devsonni/Community-Extrusion-Compression-Moulding-Machies/README.md

# Community Extrusion & Compression Moulding Machines
