devsonni/Community-Extrusion-Compression-Moulding-Machies/Precious Plastic Parts (3D CAD)/EXTPRO-V1 1120.00-A Bearing Body _ Shaft.SLDASM

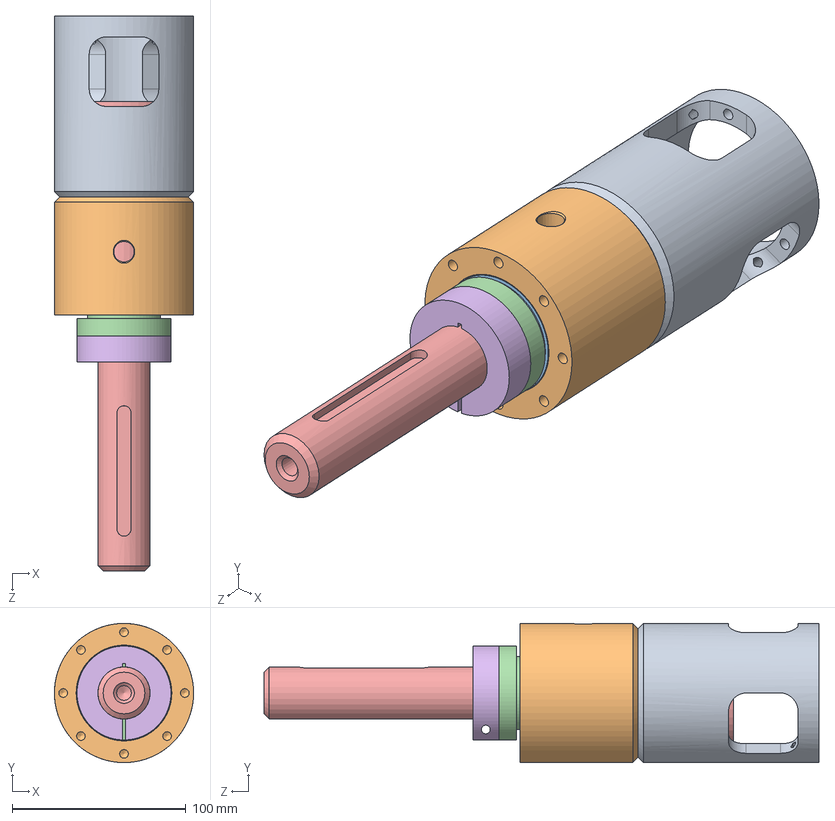
[picture p1: CAD file, 2021-08-28]
Precious Plastic Parts (3D CAD)/EXTPRO-V1 1120.00-A Bearing Body _ Shaft.SLDASM
80.0 x 80.0 x 319.0 mm
EXTPRO-V1 1121.01-A Transition Piece
EXTPRO-V1 1121.02-A Bearing body
EXTPRO-V1 02 Bearing seal-din3760-as_42x55x8-fkm x 2
EXTPRO-V1 1120.01-A Seal bearing spacer
EXTPRO-V1 1120.02-A Coupling Shaft
EXTPRO-V1 03 Shaft Clamp
