devsonni/Community-Extrusion-Compression-Moulding-Machies/Precious Plastic Parts (3D CAD)/EXTPRO-V1 3000.01-A Main frame.SLDPRT

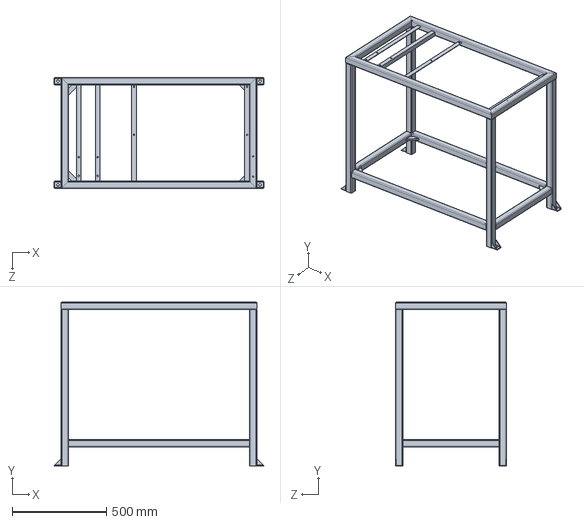
[picture p2: CAD file, 2021-08-28]
Precious Plastic Parts (3D CAD)/EXTPRO-V1 3000.01-A Main frame.SLDPRT
1114.8 x 870.0 x 590.0 mm
