devsonni/Community-Extrusion-Compression-Moulding-Machies/Precious Plastic Parts (3D CAD)/EXTPRO-V1 3000.00-A Frame.SLDASM

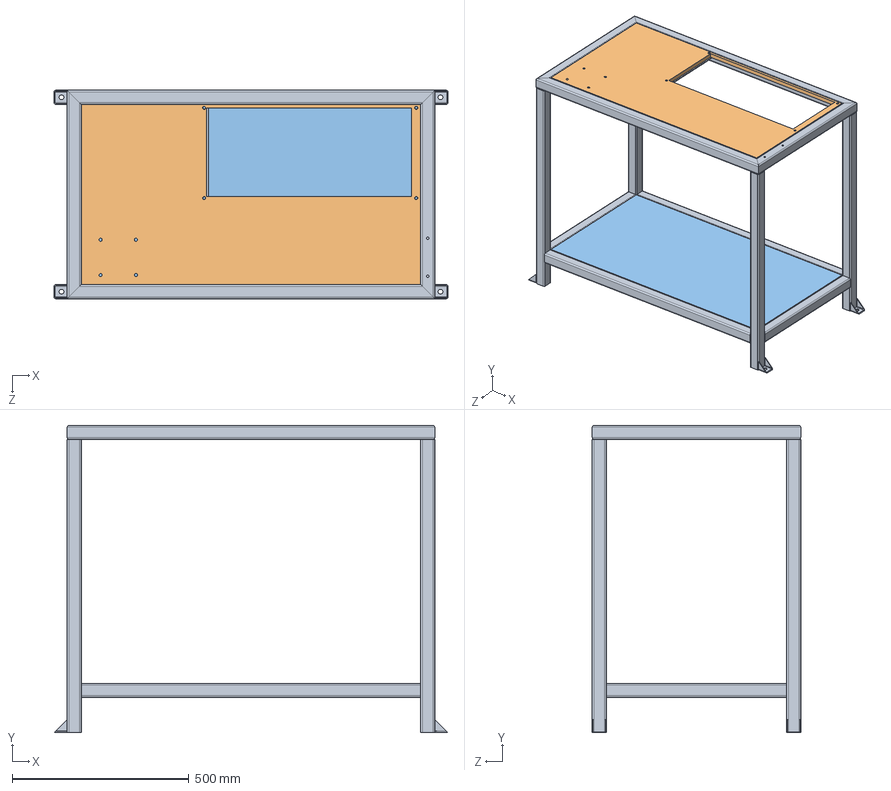
[picture p3: CAD file, 2021-08-28]
Precious Plastic Parts (3D CAD)/EXTPRO-V1 3000.00-A Frame.SLDASM
1114.8 x 870.0 x 590.0 mm
EXTPRO-V1 3000.01-A Main frame
EXTPRO-V1 3000.02-A Top shelf
EXTPRO-V1 3000.03-A Bottom shelf
