devsonni/Community-Extrusion-Compression-Moulding-Machies/Precious Plastic Parts (3D CAD)/EXTPRO-V1 1130.00-A Barrel inlet.SLDASM

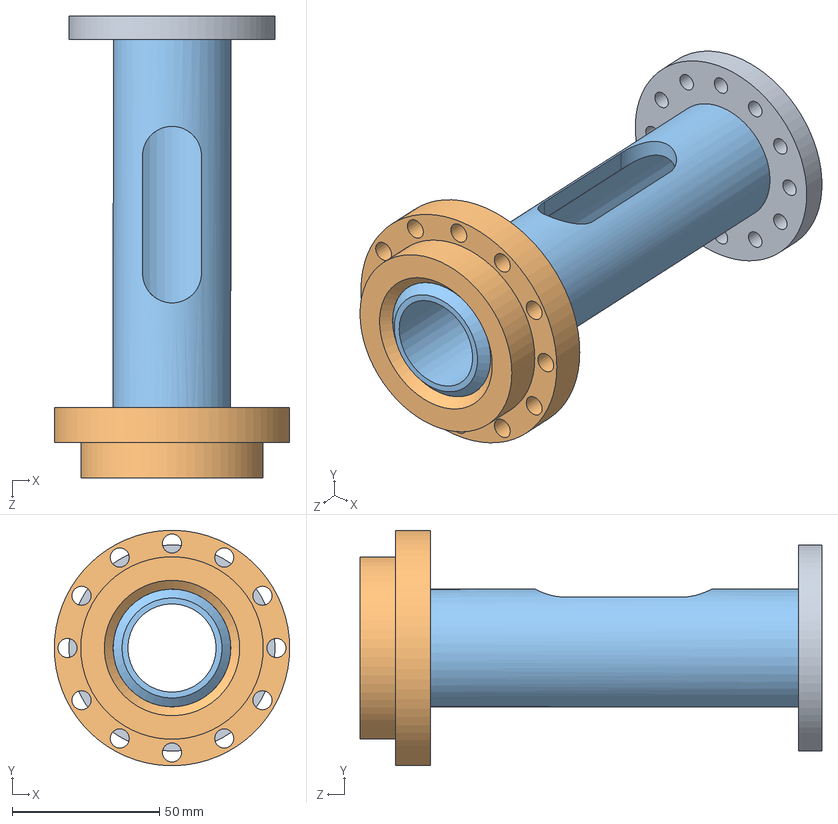
[picture p4: CAD file, 2021-08-28]
Precious Plastic Parts (3D CAD)/EXTPRO-V1 1130.00-A Barrel inlet.SLDASM
80.0 x 79.9 x 157.0 mm
EXTPRO-V1 1130.01-A Barrel inlet
EXTPRO-V1 1130.02-A Barrel flange 1
EXTPRO-V1 1130.03-A Barrel flange 2
