devsonni/Community-Extrusion-Compression-Moulding-Machies/Precious Plastic Parts (3D CAD)/Bearing Body Assembly.SLDASM

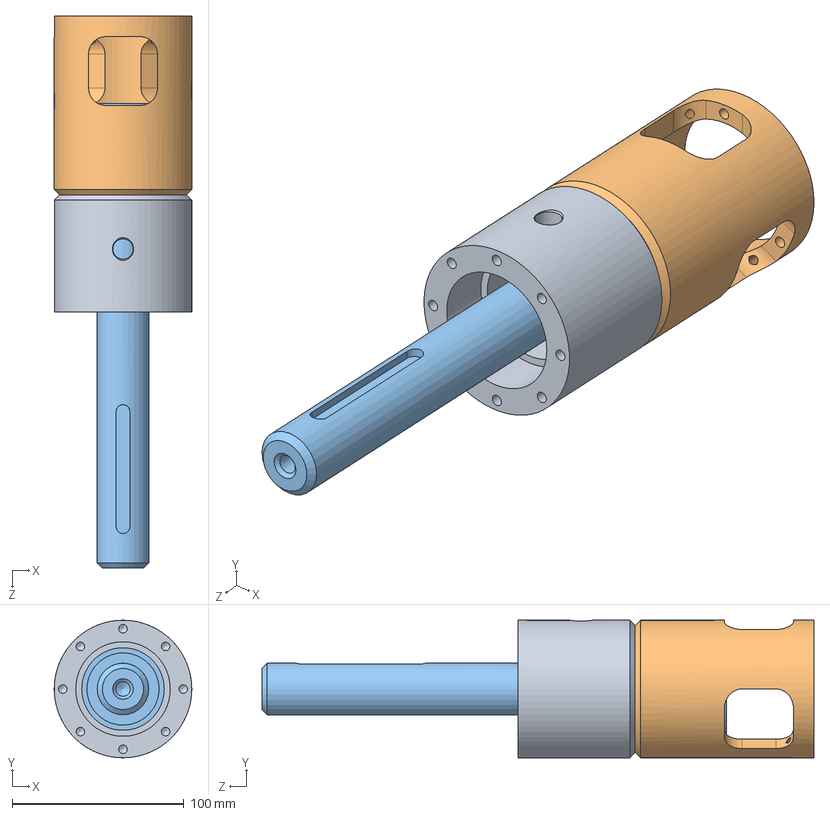
[picture p5: CAD file, 2021-08-28]
Precious Plastic Parts (3D CAD)/Bearing Body Assembly.SLDASM
80.0 x 80.0 x 321.0 mm
EXTPRO-V1 1121.02-A Bearing body
EXTPRO-V1 1121.01-A Transition Piece
EXTPRO-V1 1120.02-A Coupling Shaft
