devsonni/Community-Extrusion-Compression-Moulding-Machies/Precious Plastic Parts (3D CAD)/EXTPRO-V1 1140.00-A Barrel.SLDASM

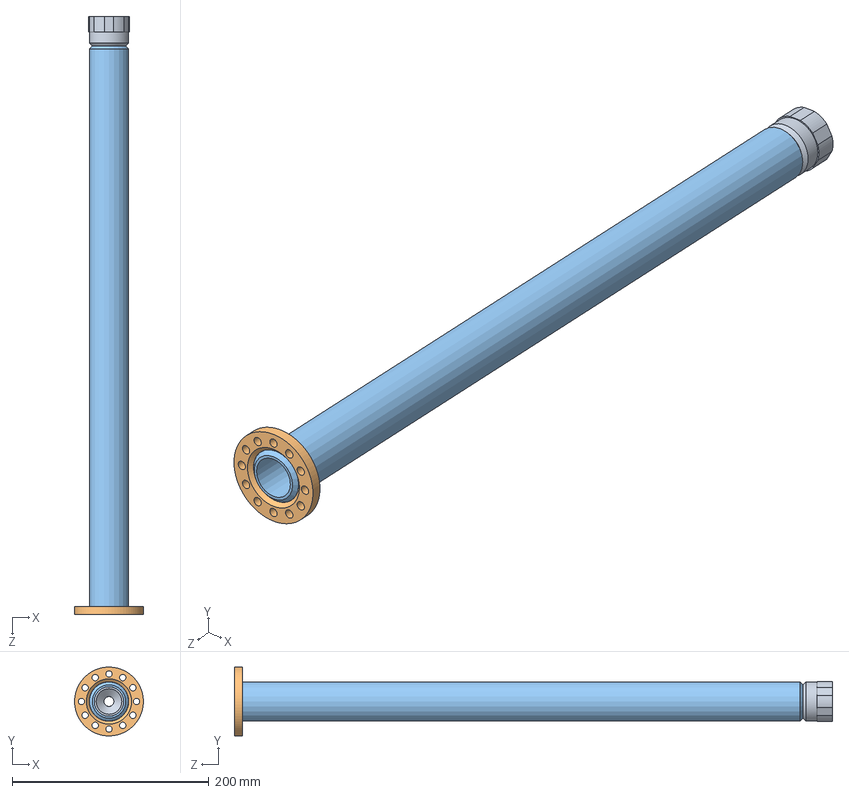
[picture p6: CAD file, 2021-08-28]
Precious Plastic Parts (3D CAD)/EXTPRO-V1 1140.00-A Barrel.SLDASM
70.0 x 70.0 x 608.0 mm
EXTPRO-V1 1140.01-A Barrel
EXTPRO-V1 1140.02-A Barrel flange
EXTPRO-V1 1140.03-A Barrel tip
