devsonni/Community-Extrusion-Compression-Moulding-Machies/Precious Plastic Parts (3D CAD)/EXTPRO-V1 1110.00-A Gearbox flange.sldasm

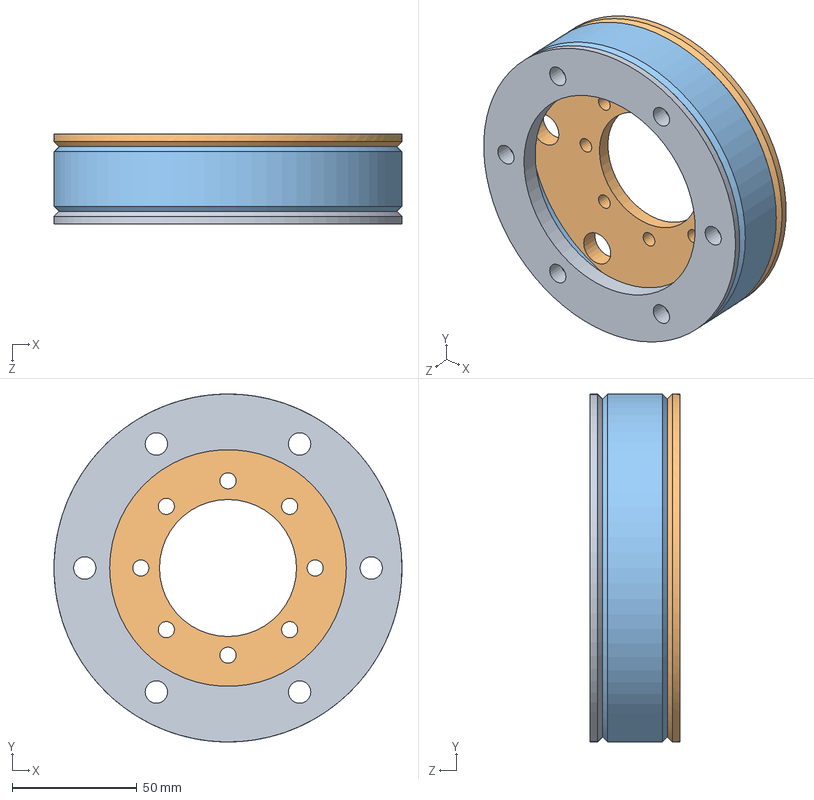
[picture p7: CAD file, 2021-08-28]
Precious Plastic Parts (3D CAD)/EXTPRO-V1 1110.00-A Gearbox flange.sldasm
139.7 x 139.7 x 36.0 mm
EXTPRO-V1 1110.01-A Flange Spacer
EXTPRO-V1 1110.02-A Flange 1
EXTPRO-V1 1110.03-A Flange 2
