devsonni/Community-Extrusion-Compression-Moulding-Machies/Precious Plastic Parts (3D CAD)/EXTPRO-V1 1200.00-A Cone Hopper.SLDASM

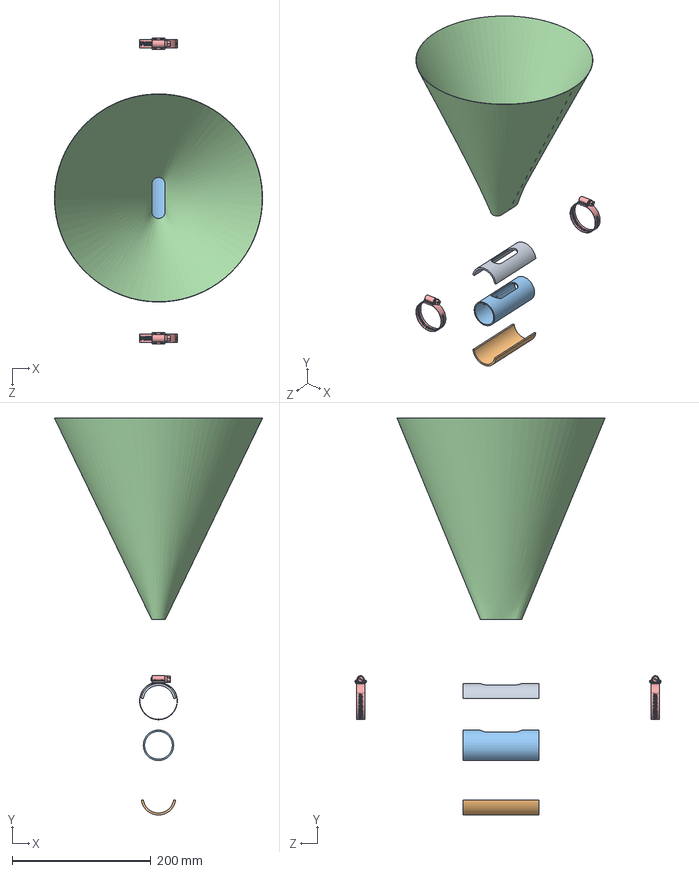
[picture p8: CAD file, 2021-08-28]
Precious Plastic Parts (3D CAD)/EXTPRO-V1 1200.00-A Cone Hopper.SLDASM
300.0 x 572.2 x 441.7 mm
EXTPRO-V1 1200.01-A Top
EXTPRO-V1 1200.02-A Bottom
EXTPRO-V1 1200.03-A Insulation
EXTPRO-V1 1200.04-A Cone
EXTPRO-V1 10 Clamp x 2
