devsonni/Community-Extrusion-Compression-Moulding-Machies/Precious Plastic Parts (3D CAD)/EXTPRO-V1 1121.00-A Bearing body.SLDASM

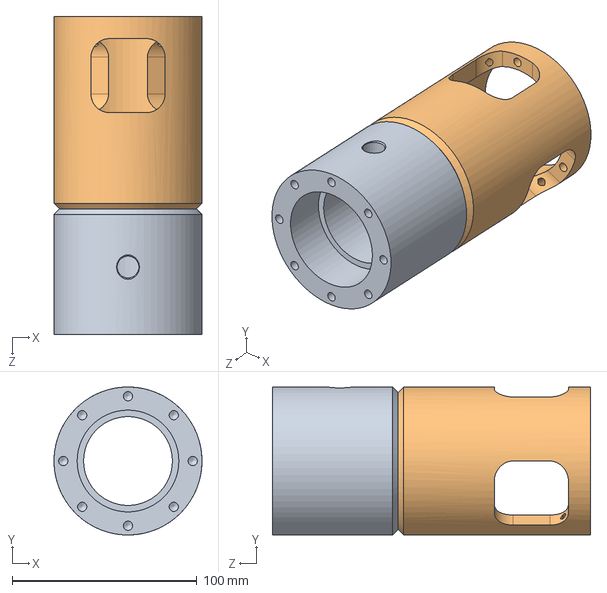
[picture p9: CAD file, 2021-08-28]
Precious Plastic Parts (3D CAD)/EXTPRO-V1 1121.00-A Bearing body.SLDASM
80.0 x 80.0 x 172.0 mm
EXTPRO-V1 1121.01-A Transition Piece
EXTPRO-V1 1121.02-A Bearing body
