devsonni/Community-Extrusion-Compression-Moulding-Machies/Laser cut files/Modified laser cut files/Flange2_QTY_1.dxf

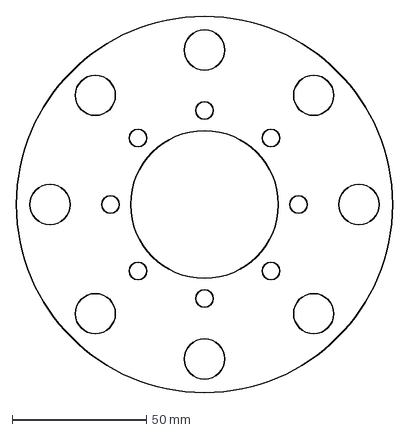
[picture p10: CAD file, 2021-08-31]
Laser cut files/Modified laser cut files/Flange2_QTY_1.dxf
140.0 x 140.0 mm
