devsonni/Community-Extrusion-Compression-Moulding-Machies/Laser cut files/Precious Plastic/EXTPRO-V1 2100.05-A Side 3 - QTY_2.DXF

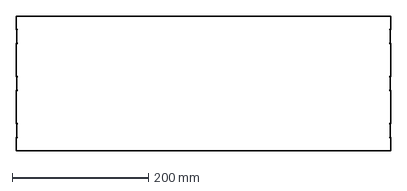
[picture p11: CAD file, 2021-08-31]
Laser cut files/Precious Plastic/EXTPRO-V1 2100.05-A Side 3 - QTY_2.DXF
550.0 x 198.0 mm
