devsonni/Community-Extrusion-Compression-Moulding-Machies/Laser cut files/Modified laser cut files/Flange1_QTY_1.DXF

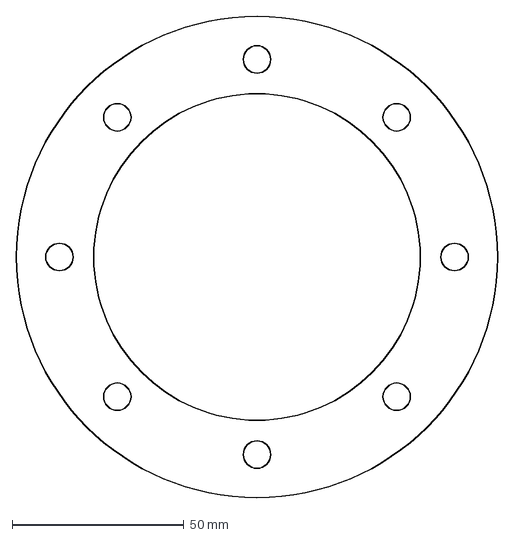
[picture p12: CAD file, 2021-08-31]
Laser cut files/Modified laser cut files/Flange1_QTY_1.DXF
140.0 x 140.0 mm
