devsonni/Community-Extrusion-Compression-Moulding-Machies/Laser cut files/Precious Plastic/EXTPRO-V1 2100.01-A Cover - QTY_1.DXF

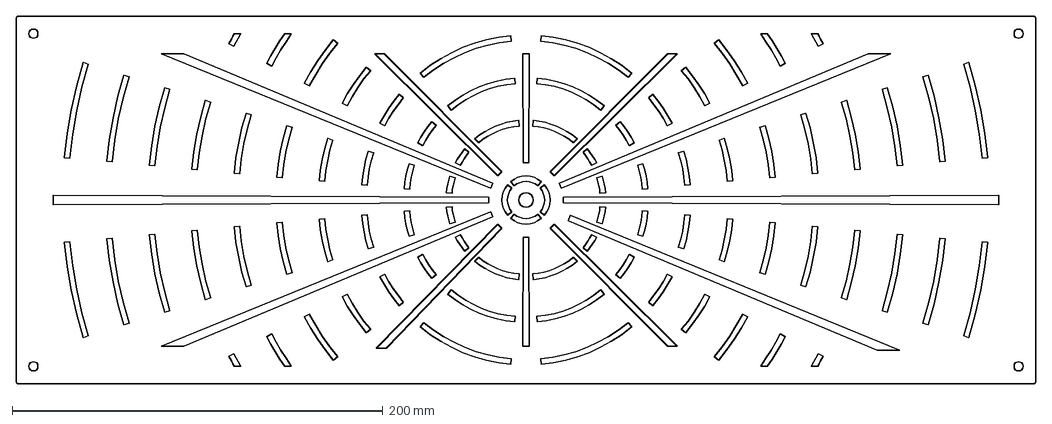
[picture p13: CAD file, 2021-08-31]
Laser cut files/Precious Plastic/EXTPRO-V1 2100.01-A Cover - QTY_1.DXF
550.0 x 198.0 mm
