devsonni/Community-Extrusion-Compression-Moulding-Machies/Precious Plastic Parts (3D CAD)/EXTPRO-V1 2100.01-A Cover.SLDPRT

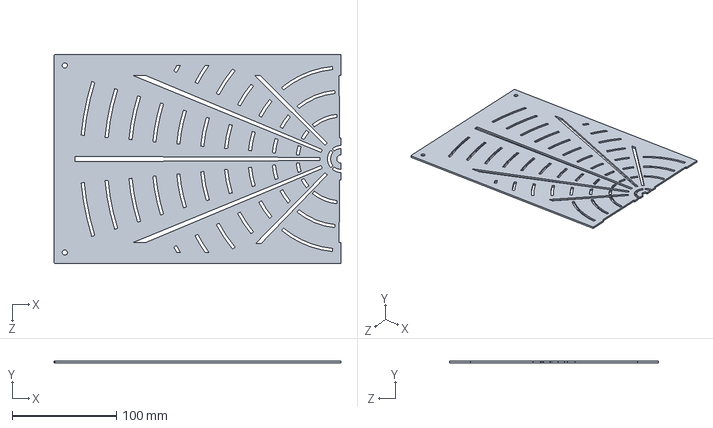
[picture p14: CAD file, 2021-08-28]
Precious Plastic Parts (3D CAD)/EXTPRO-V1 2100.01-A Cover.SLDPRT
275.0 x 2.00 x 200.0 mm
