devsonni/Community-Extrusion-Compression-Moulding-Machies/Laser cut files/Modified laser cut files/Front_Electrical_QTY_1.DXF

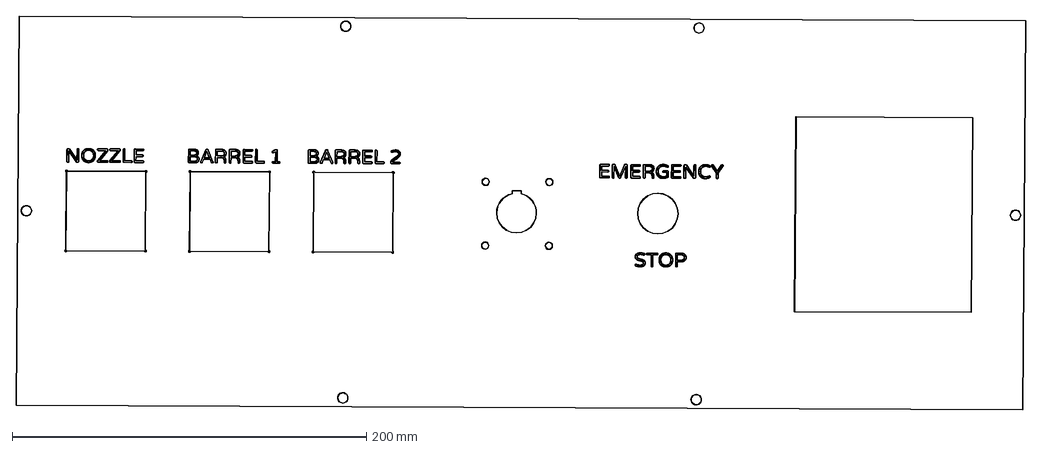
[picture p15: CAD file, 2021-08-31]
Laser cut files/Modified laser cut files/Front_Electrical_QTY_1.DXF
570.2 x 222.4 mm
