devsonni/Community-Extrusion-Compression-Moulding-Machies/Laser cut files/Precious Plastic/EXTPRO-V1 2100.03-A Side 2 - QTY_1.DXF

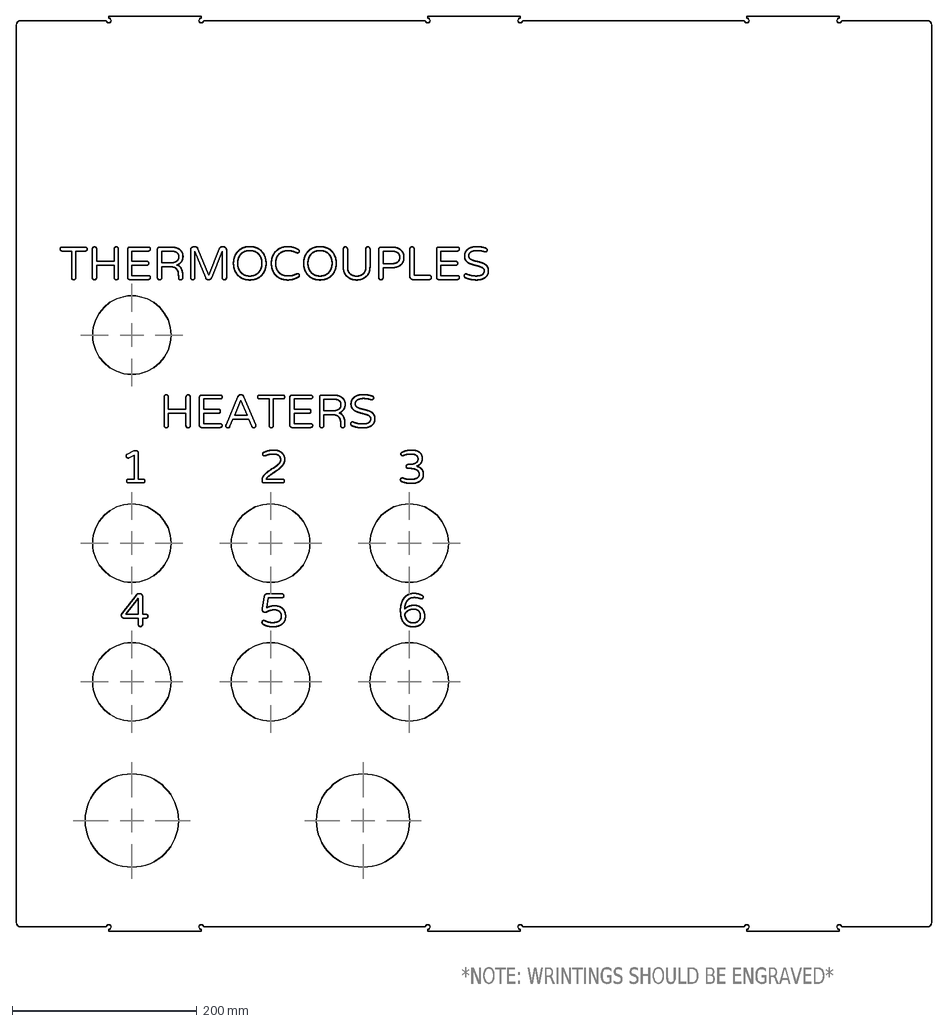
[picture p16: CAD file, 2021-08-31]
Laser cut files/Precious Plastic/EXTPRO-V1 2100.03-A Side 2 - QTY_1.DXF
*NOTE: WRINTINGS SHOULD BE ENGRAVED*
