devsonni/Community-Extrusion-Compression-Moulding-Machies/Precious Plastic Parts (3D CAD)/EXTPRO-V1 1140.02-A Barrel flange.sldprt

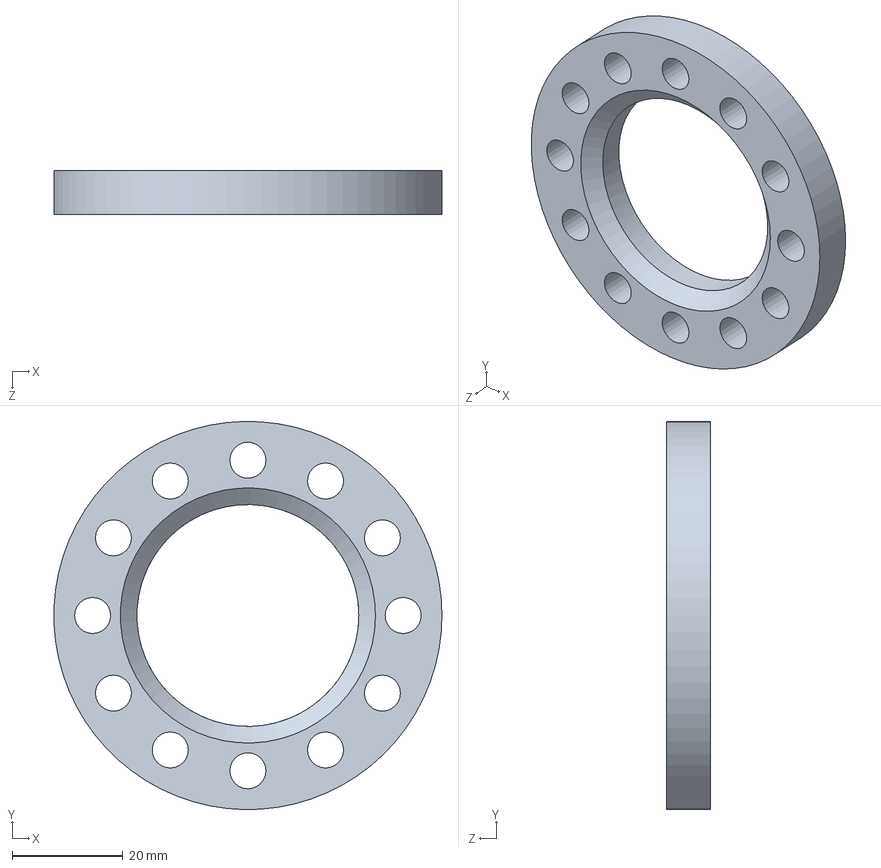
[picture p17: CAD file, 2021-08-28]
Precious Plastic Parts (3D CAD)/EXTPRO-V1 1140.02-A Barrel flange.sldprt
70.0 x 70.0 x 8.00 mm
