devsonni/Community-Extrusion-Compression-Moulding-Machies/Laser cut files/Precious Plastic/EXTPRO-V1 2100.04-A Side 1 - QTY_1.DXF

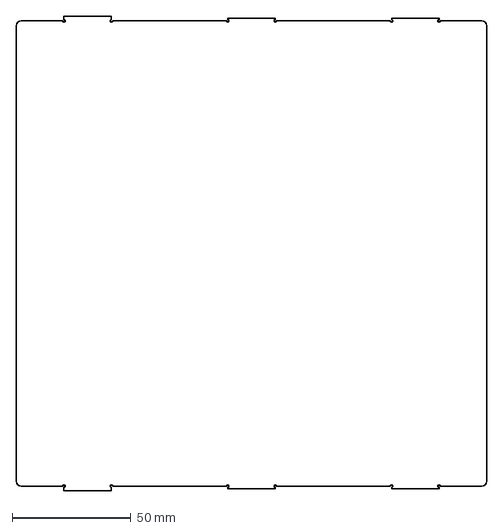
[picture p18: CAD file, 2021-08-31]
Laser cut files/Precious Plastic/EXTPRO-V1 2100.04-A Side 1 - QTY_1.DXF
198.0 x 200.0 mm
