devsonni/Community-Extrusion-Compression-Moulding-Machies/Precious Plastic Parts (3D CAD)/EXTPRO-V1 21 E Stop Button.SLDPRT

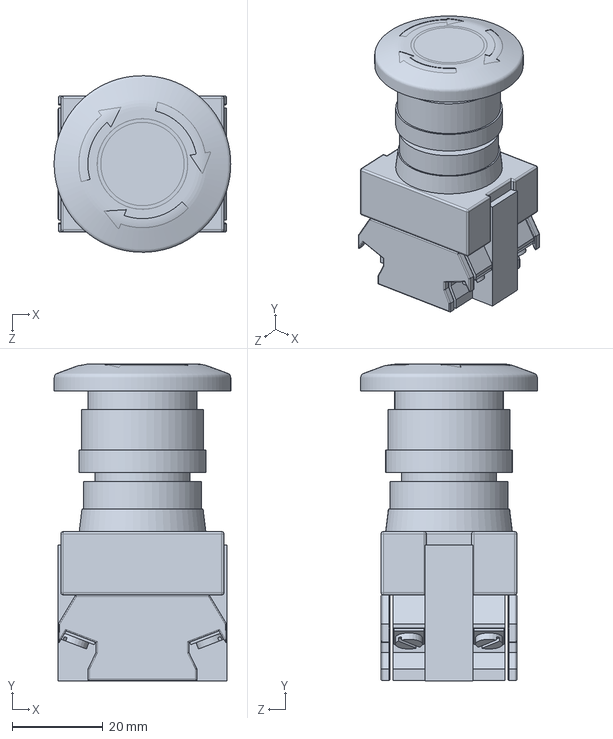
[picture p19: CAD file, 2021-08-28]
Precious Plastic Parts (3D CAD)/EXTPRO-V1 21 E Stop Button.SLDPRT
39.0 x 70.0 x 39.0 mm
