devsonni/Community-Extrusion-Compression-Moulding-Machies/Precious Plastic Parts (3D CAD)/EXTPRO-V1 18 Solid state relay.SLDPRT

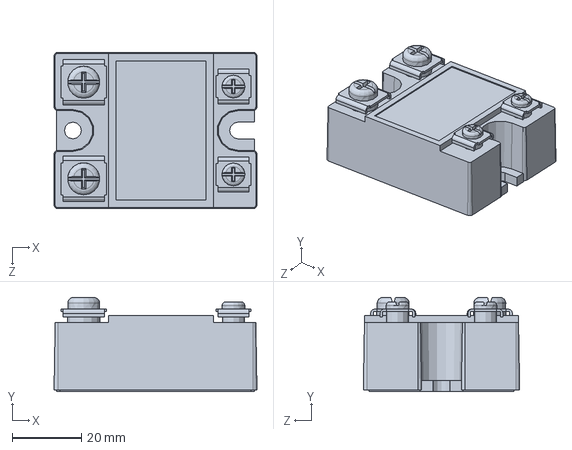
[picture p20: CAD file, 2021-08-28]
Precious Plastic Parts (3D CAD)/EXTPRO-V1 18 Solid state relay.SLDPRT
58.7 x 27.2 x 45.2 mm
