devsonni/Community-Extrusion-Compression-Moulding-Machies/Precious Plastic Parts (3D CAD)/EXTPRO-V1 2100.04-A Side 1.SLDPRT

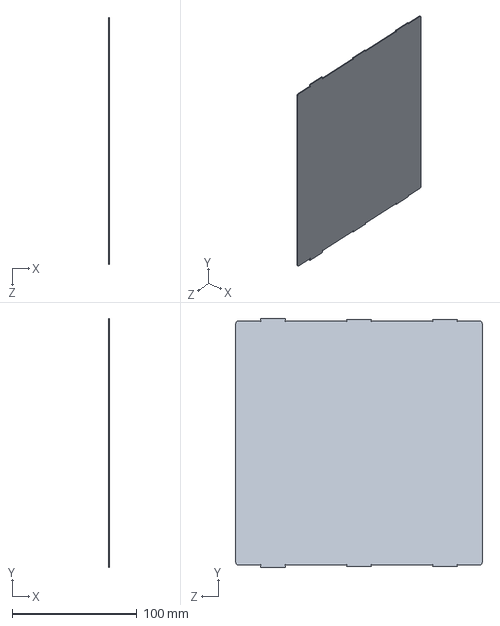
[picture p21: CAD file, 2021-08-28]
Precious Plastic Parts (3D CAD)/EXTPRO-V1 2100.04-A Side 1.SLDPRT
1.00 x 200.0 x 198.0 mm
