devsonni/Community-Extrusion-Compression-Moulding-Machies/Precious Plastic Parts (3D CAD)/EXTPRO-V1 1100.01-A Nozzle.sldprt

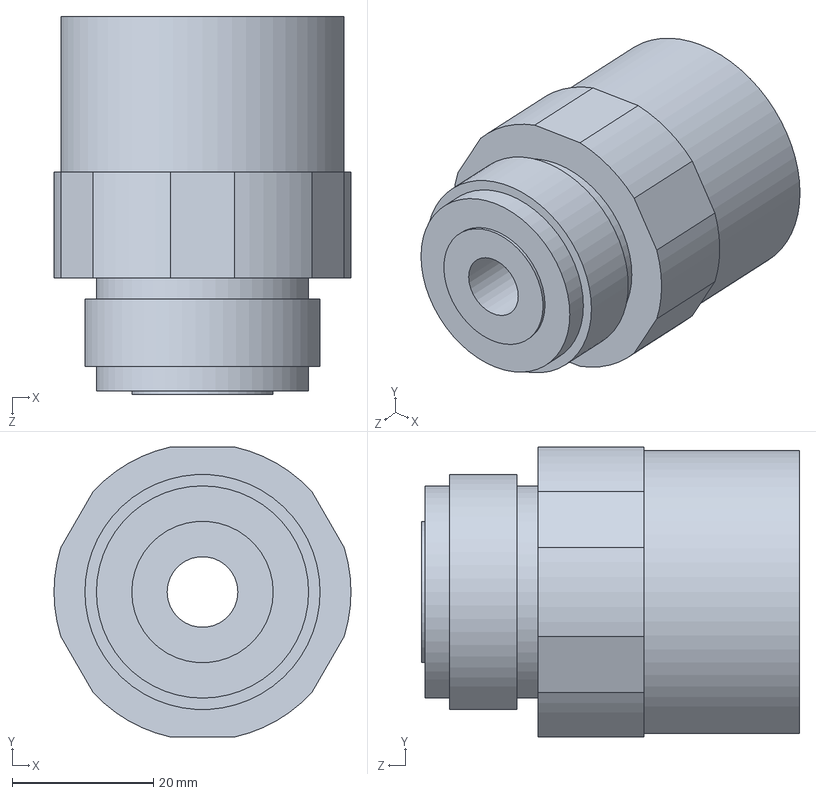
[picture p22: CAD file, 2021-08-28]
Precious Plastic Parts (3D CAD)/EXTPRO-V1 1100.01-A Nozzle.sldprt
42.0 x 41.0 x 53.5 mm
