devsonni/Community-Extrusion-Compression-Moulding-Machies/Precious Plastic Parts (3D CAD)/EXTPRO-V1 2100.05-A Side 3.SLDPRT

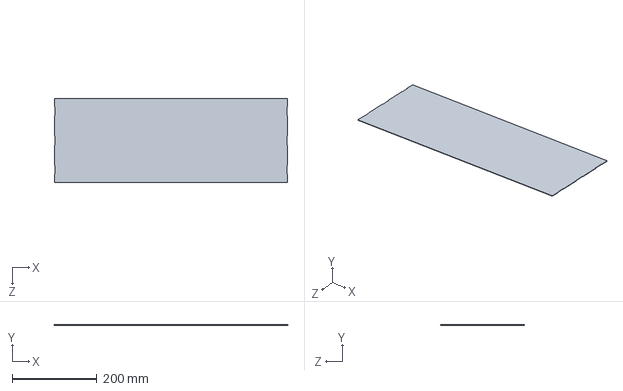
[picture p23: CAD file, 2021-08-28]
Precious Plastic Parts (3D CAD)/EXTPRO-V1 2100.05-A Side 3.SLDPRT
550.0 x 1.00 x 198.0 mm
