devsonni/Community-Extrusion-Compression-Moulding-Machies/Precious Plastic Parts (3D CAD)/EXTPRO-V1 1110.02-A Flange 1.sldprt

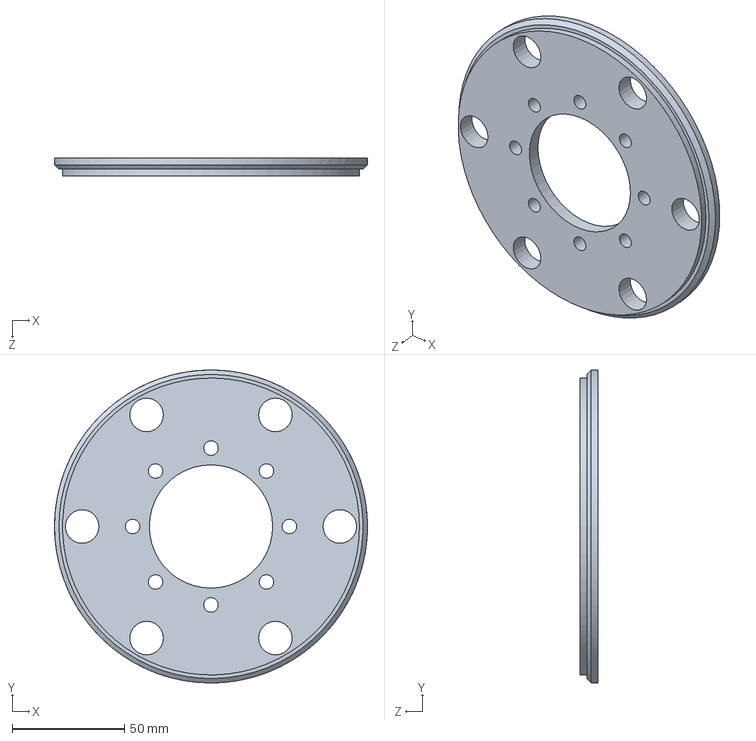
[picture p24: CAD file, 2021-08-28]
Precious Plastic Parts (3D CAD)/EXTPRO-V1 1110.02-A Flange 1.sldprt
139.7 x 139.7 x 8.00 mm
