devsonni/Community-Extrusion-Compression-Moulding-Machies/Precious Plastic Parts (3D CAD)/EXTPRO-V1 1140.01-A Barrel.sldprt

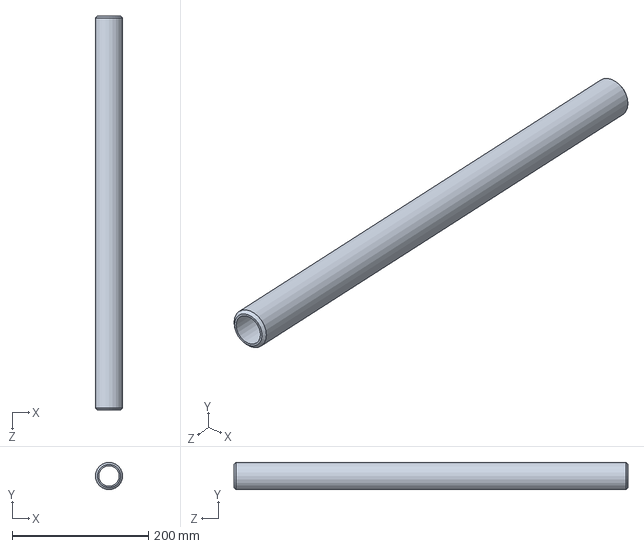
[picture p25: CAD file, 2021-08-28]
Precious Plastic Parts (3D CAD)/EXTPRO-V1 1140.01-A Barrel.sldprt
40.0 x 40.0 x 578.0 mm
