devsonni/Community-Extrusion-Compression-Moulding-Machies/Precious Plastic Parts (3D CAD)/EXTPRO-V1 16 PID Controller.SLDPRT

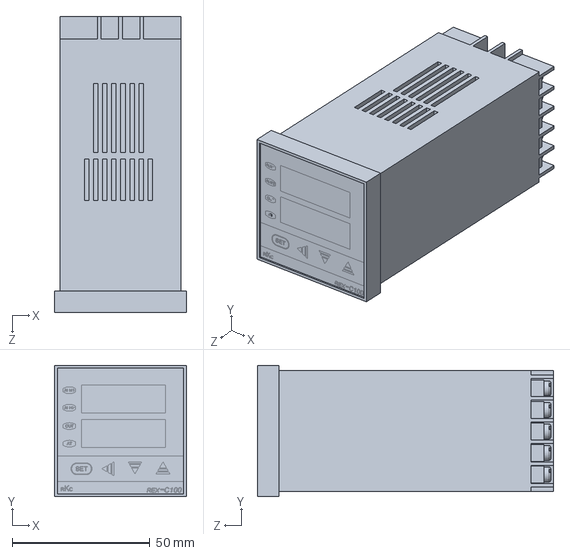
[picture p26: CAD file, 2021-08-28]
Precious Plastic Parts (3D CAD)/EXTPRO-V1 16 PID Controller.SLDPRT
47.8 x 47.6 x 107.4 mm
