devsonni/Community-Extrusion-Compression-Moulding-Machies/Precious Plastic Parts (3D CAD)/EXTPRO-V1 1130.03-A Barrel flange 2.sldprt

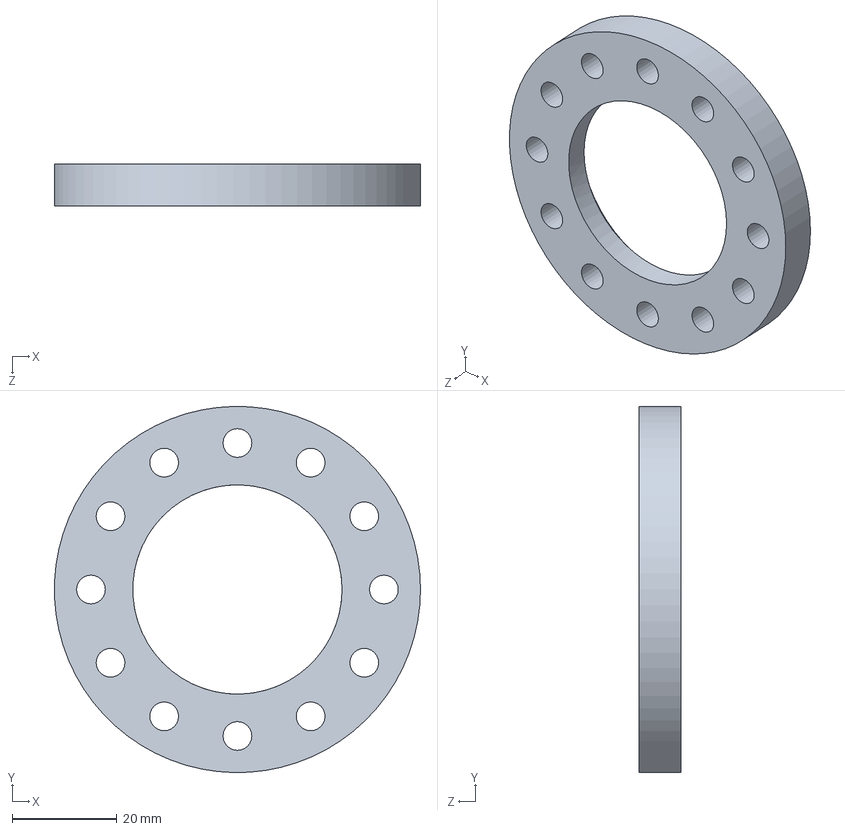
[picture p27: CAD file, 2021-08-28]
Precious Plastic Parts (3D CAD)/EXTPRO-V1 1130.03-A Barrel flange 2.sldprt
70.0 x 70.0 x 8.00 mm
