devsonni/Community-Extrusion-Compression-Moulding-Machies/Precious Plastic Parts (3D CAD)/EXTPRO-V1 1130.01-A Barrel inlet.SLDPRT

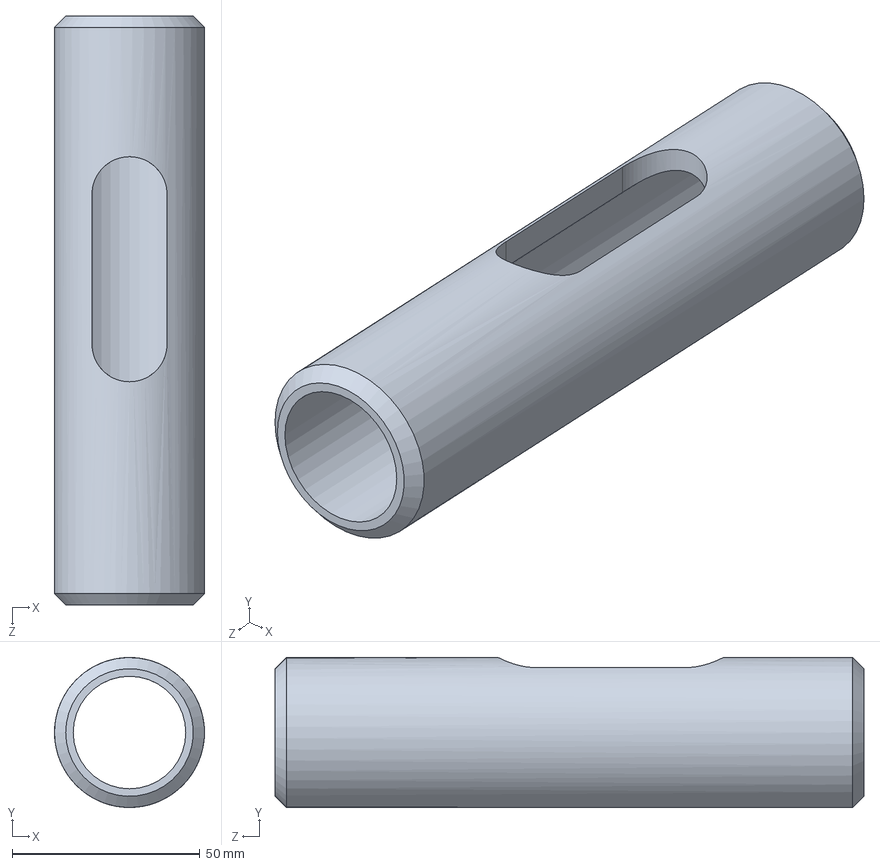
[picture p28: CAD file, 2021-08-28]
Precious Plastic Parts (3D CAD)/EXTPRO-V1 1130.01-A Barrel inlet.SLDPRT
40.0 x 40.0 x 157.0 mm
