devsonni/Community-Extrusion-Compression-Moulding-Machies/Precious Plastic Parts (3D CAD)/EXTPRO-V1 1120.01-A Seal bearing spacer.sldprt

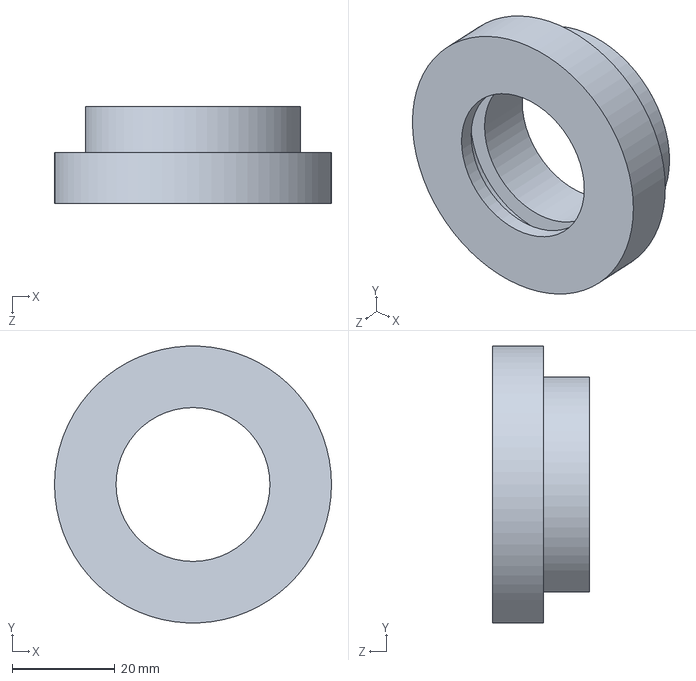
[picture p29: CAD file, 2021-08-28]
Precious Plastic Parts (3D CAD)/EXTPRO-V1 1120.01-A Seal bearing spacer.sldprt
54.0 x 53.9 x 19.0 mm
