devsonni/Community-Extrusion-Compression-Moulding-Machies/Precious Plastic Parts (3D CAD)/EXTPRO-V1 1121.02-A Bearing body.sldprt

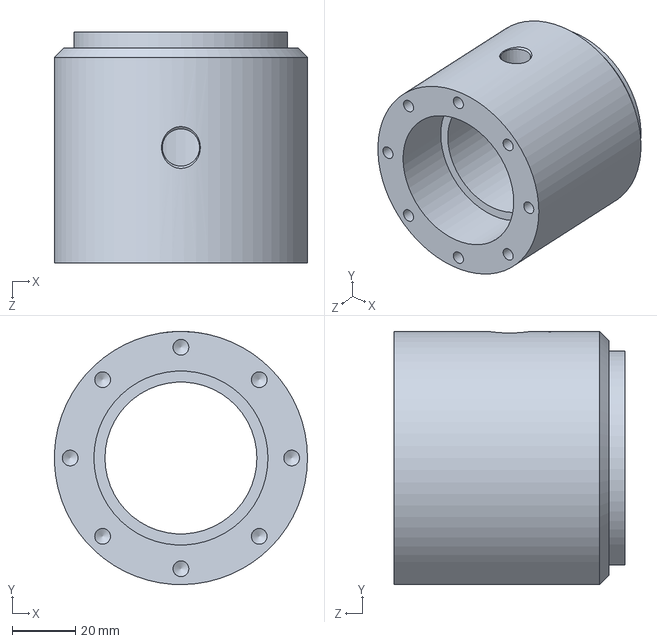
[picture p30: CAD file, 2021-08-28]
Precious Plastic Parts (3D CAD)/EXTPRO-V1 1121.02-A Bearing body.sldprt
80.0 x 80.0 x 73.0 mm
