devsonni/Community-Extrusion-Compression-Moulding-Machies/Precious Plastic Parts (3D CAD)/EXTPRO-V1 1120.02-A Coupling Shaft.sldprt

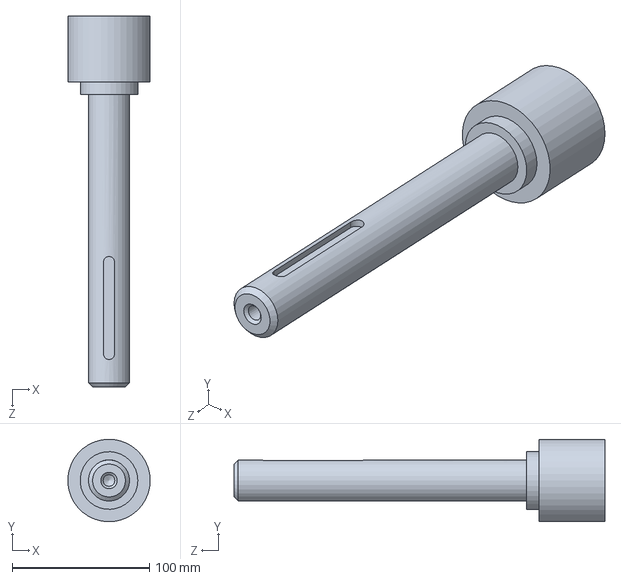
[picture p31: CAD file, 2021-08-28]
Precious Plastic Parts (3D CAD)/EXTPRO-V1 1120.02-A Coupling Shaft.sldprt
60.0 x 60.0 x 270.0 mm
