devsonni/Community-Extrusion-Compression-Moulding-Machies/Precious Plastic Parts (3D CAD)/EXTPRO-V1 2100.02-A Front.SLDPRT

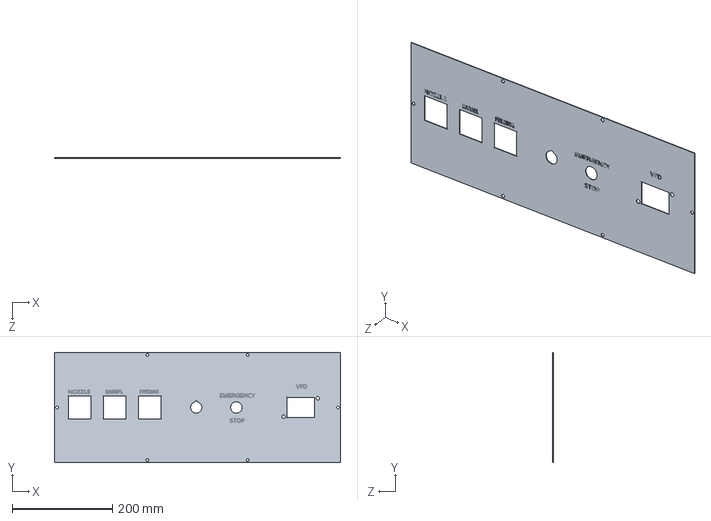
[picture p32: CAD file, 2021-08-28]
Precious Plastic Parts (3D CAD)/EXTPRO-V1 2100.02-A Front.SLDPRT
570.0 x 220.0 x 1.00 mm
