devsonni/Community-Extrusion-Compression-Moulding-Machies/Precious Plastic Parts (3D CAD)/EXTPRO-V1 24 Cable gland M20.SLDPRT

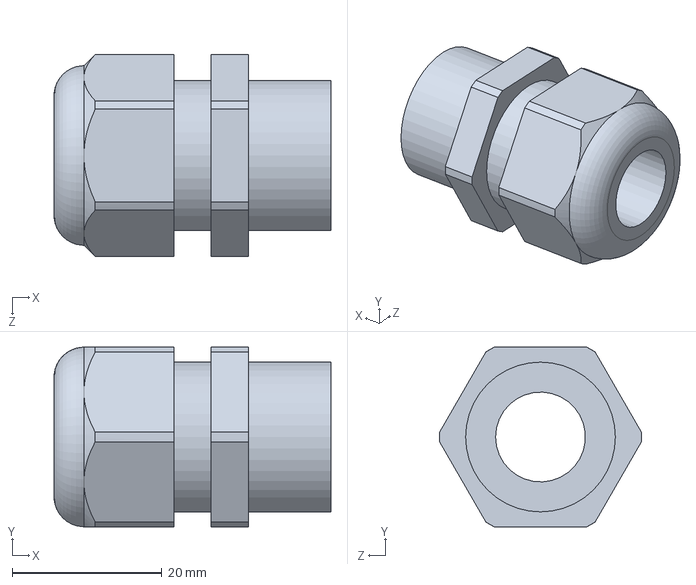
[picture p33: CAD file, 2021-08-28]
Precious Plastic Parts (3D CAD)/EXTPRO-V1 24 Cable gland M20.SLDPRT
37.0 x 24.0 x 27.0 mm
