devsonni/Community-Extrusion-Compression-Moulding-Machies/Precious Plastic Parts (3D CAD)/EXTPRO-V1 1121.01-A Transition Piece.sldprt

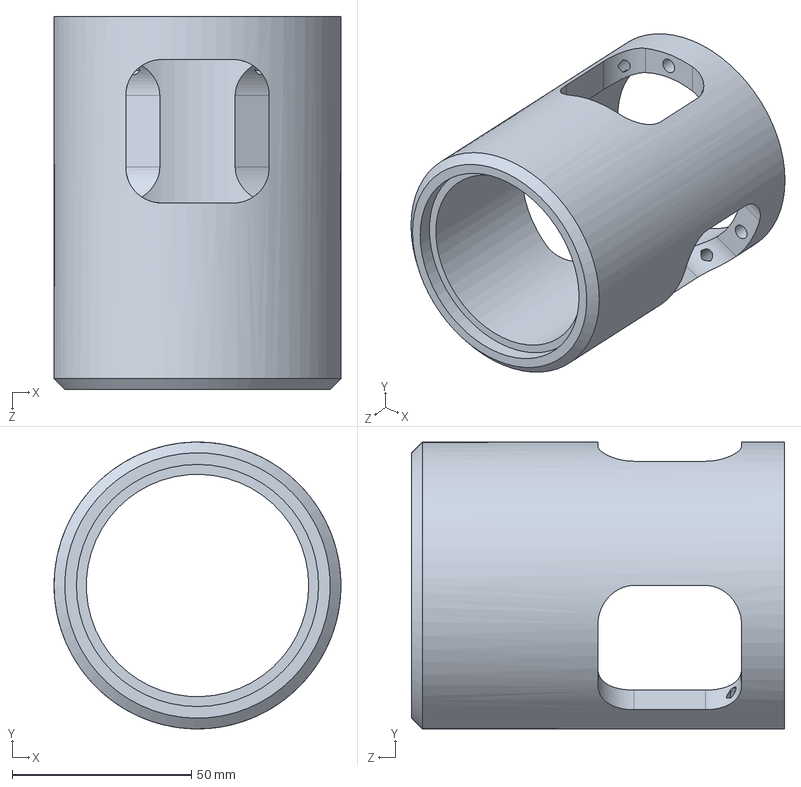
[picture p34: CAD file, 2021-08-28]
Precious Plastic Parts (3D CAD)/EXTPRO-V1 1121.01-A Transition Piece.sldprt
80.0 x 80.0 x 104.0 mm
