devsonni/Community-Extrusion-Compression-Moulding-Machies/Precious Plastic Parts (3D CAD)/EXTPRO-V1 20 3 Pole switch.SLDPRT

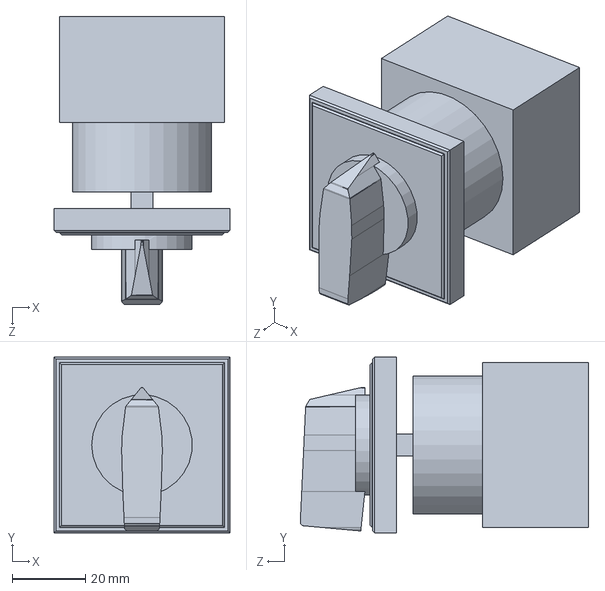
[picture p35: CAD file, 2021-08-28]
Precious Plastic Parts (3D CAD)/EXTPRO-V1 20 3 Pole switch.SLDPRT
48.0 x 48.0 x 78.7 mm
