devsonni/Community-Extrusion-Compression-Moulding-Machies/Precious Plastic Parts (3D CAD)/EXTPRO-V1 3000.02-A Support.SLDPRT

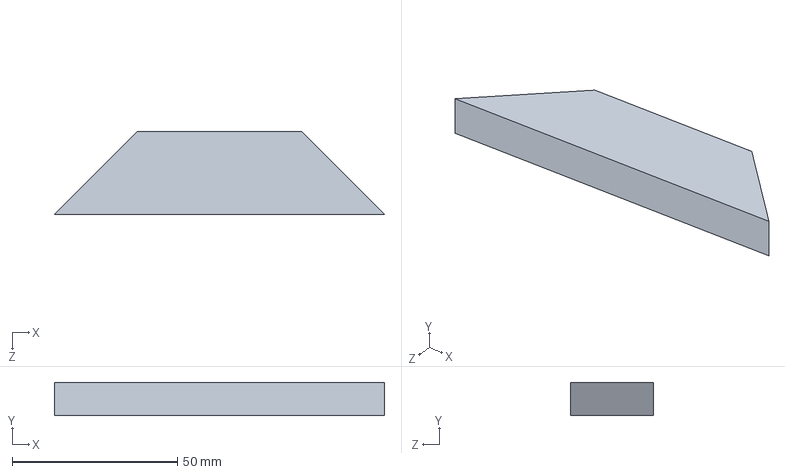
[picture p36: CAD file, 2021-08-28]
Precious Plastic Parts (3D CAD)/EXTPRO-V1 3000.02-A Support.SLDPRT
100.0 x 10.0 x 25.0 mm
