devsonni/Community-Extrusion-Compression-Moulding-Machies/Precious Plastic Parts (3D CAD)/EXTPRO-V1 19 Relay heat sink.SLDPRT

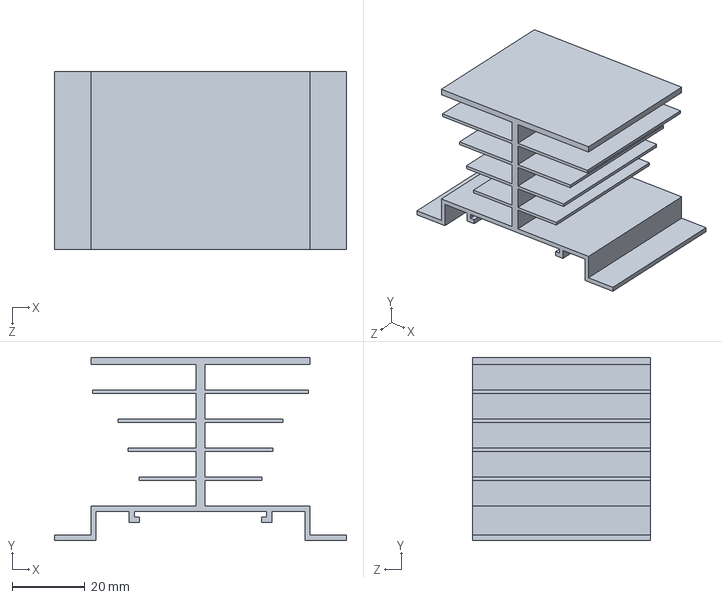
[picture p37: CAD file, 2021-08-28]
Precious Plastic Parts (3D CAD)/EXTPRO-V1 19 Relay heat sink.SLDPRT
80.5 x 50.5 x 49.0 mm
