devsonni/Community-Extrusion-Compression-Moulding-Machies/Precious Plastic Parts (3D CAD)/EXTPRO-V1 1110.01-A Flange Spacer.sldprt

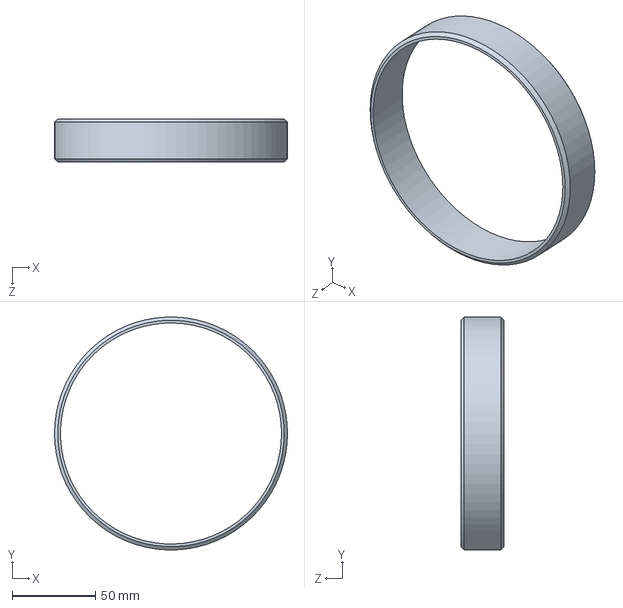
[picture p38: CAD file, 2021-08-28]
Precious Plastic Parts (3D CAD)/EXTPRO-V1 1110.01-A Flange Spacer.sldprt
139.7 x 139.6 x 26.0 mm
