devsonni/Community-Extrusion-Compression-Moulding-Machies/Precious Plastic Parts (3D CAD)/EXTPRO-V1 2100.06-A Cover attachment.SLDPRT

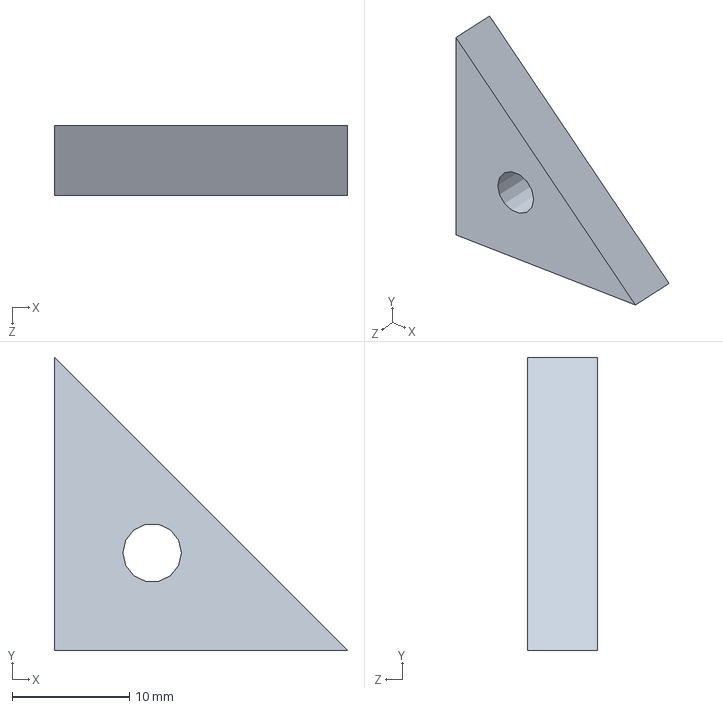
[picture p39: CAD file, 2021-08-28]
Precious Plastic Parts (3D CAD)/EXTPRO-V1 2100.06-A Cover attachment.SLDPRT
25.0 x 25.0 x 6.00 mm
