devsonni/Community-Extrusion-Compression-Moulding-Machies/Precious Plastic Parts (3D CAD)/EXTPRO-V1 1130.02-A Barrel flange 1.SLDPRT

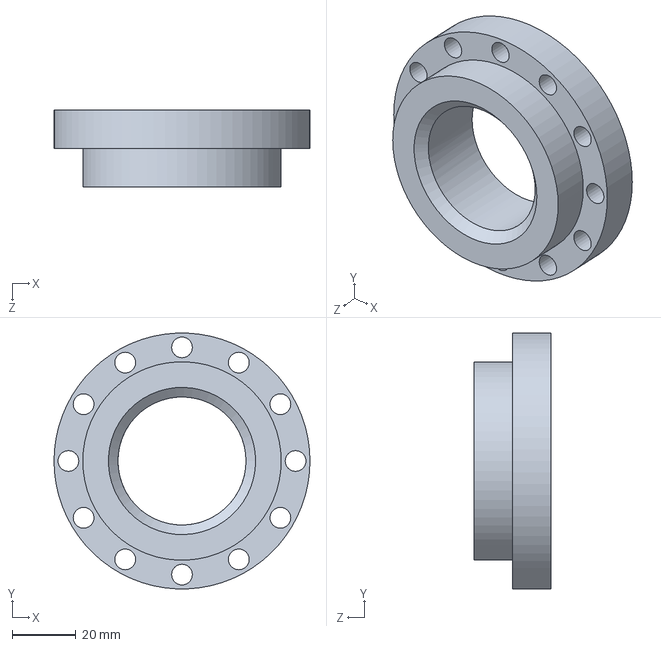
[picture p40: CAD file, 2021-08-28]
Precious Plastic Parts (3D CAD)/EXTPRO-V1 1130.02-A Barrel flange 1.SLDPRT
80.0 x 79.9 x 24.0 mm
