devsonni/Community-Extrusion-Compression-Moulding-Machies/Precious Plastic Parts (3D CAD)/EXTPRO-V1 2000.01-A Electronics box support.SLDPRT

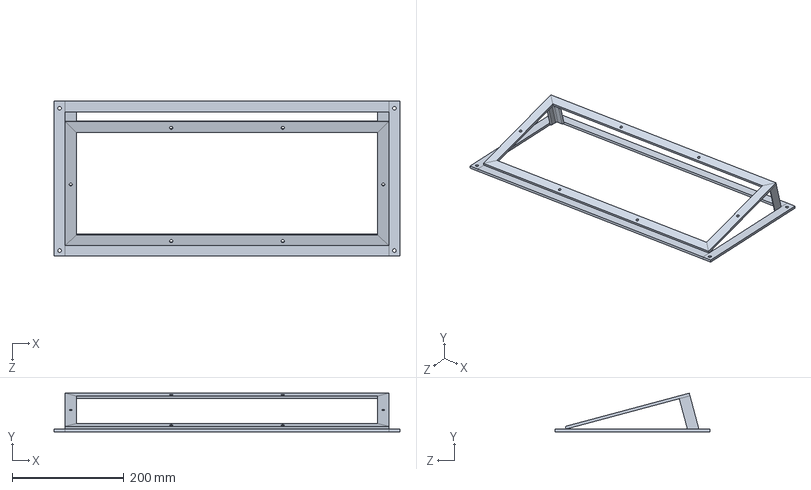
[picture p41: CAD file, 2021-08-28]
Precious Plastic Parts (3D CAD)/EXTPRO-V1 2000.01-A Electronics box support.SLDPRT
620.0 x 69.4 x 278.1 mm
