devsonni/Community-Extrusion-Compression-Moulding-Machies/Precious Plastic Parts (3D CAD)/EXTPRO-V1 2100.03-A Side 2.SLDPRT

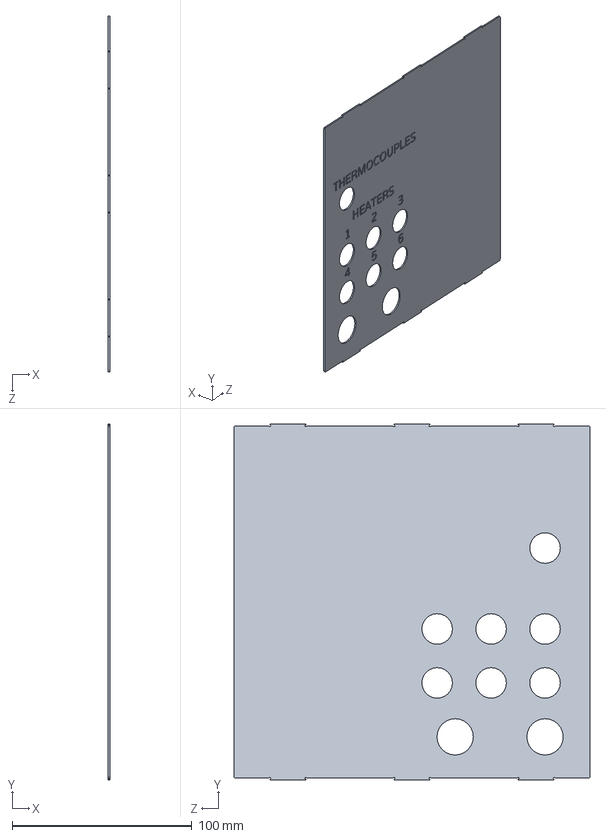
[picture p42: CAD file, 2021-08-28]
Precious Plastic Parts (3D CAD)/EXTPRO-V1 2100.03-A Side 2.SLDPRT
1.00 x 198.0 x 198.0 mm
