devsonni/Community-Extrusion-Compression-Moulding-Machies/Precious Plastic Parts (3D CAD)/EXTPRO-V1 1140.03-A Barrel tip.sldprt

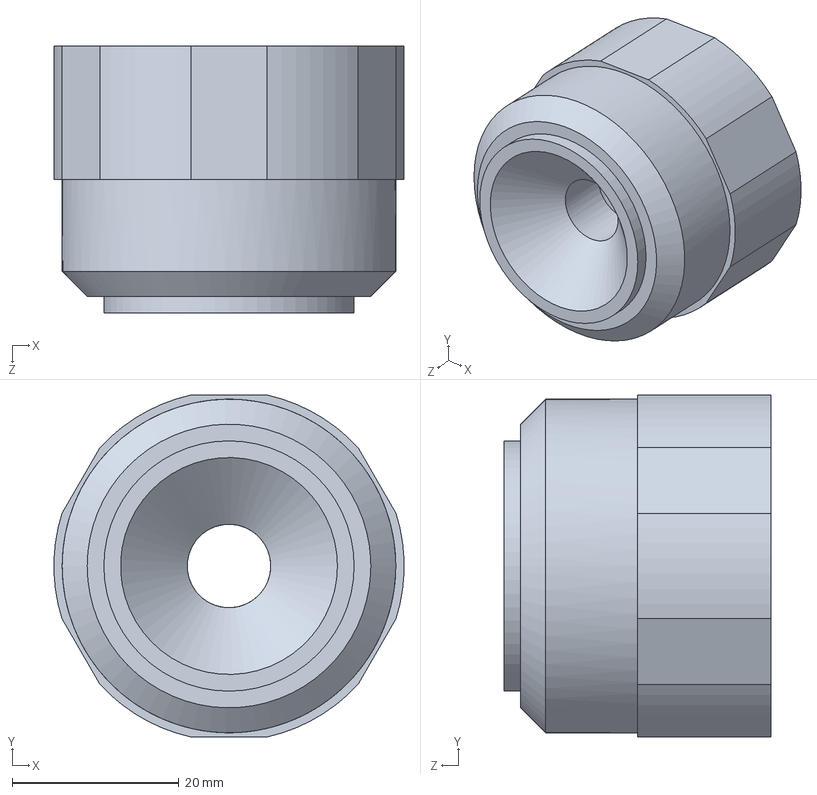
[picture p43: CAD file, 2021-08-28]
Precious Plastic Parts (3D CAD)/EXTPRO-V1 1140.03-A Barrel tip.sldprt
42.0 x 41.0 x 32.0 mm
