devsonni/Community-Extrusion-Compression-Moulding-Machies/Precious Plastic Parts (3D CAD)/EXTPRO-V1 23 Cable gland M16.SLDPRT

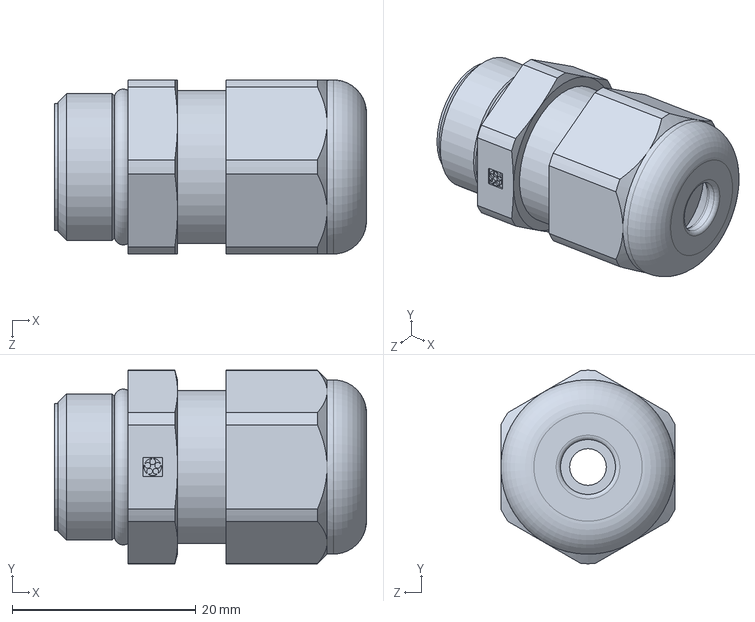
[picture p44: CAD file, 2021-08-28]
Precious Plastic Parts (3D CAD)/EXTPRO-V1 23 Cable gland M16.SLDPRT
34.0 x 21.1 x 19.0 mm
