devsonni/Community-Extrusion-Compression-Moulding-Machies/Precious Plastic Parts (3D CAD)/EXTPRO-V1 1110.03-A Flange 2.sldprt

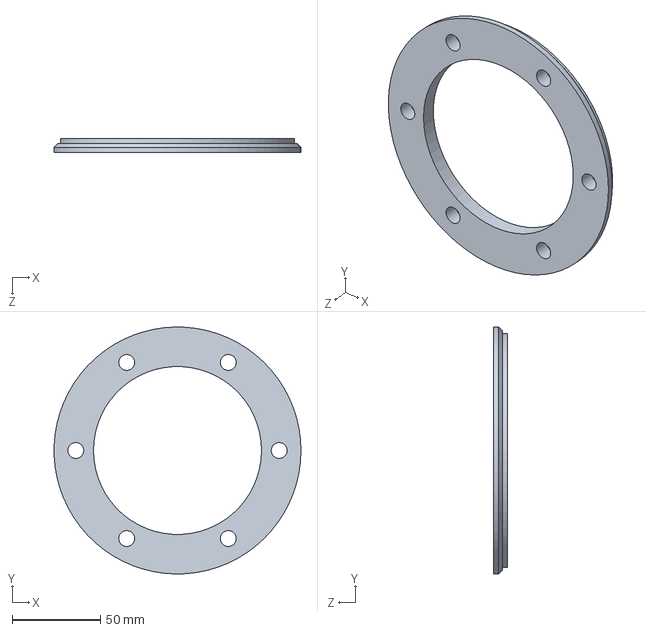
[picture p45: CAD file, 2021-08-28]
Precious Plastic Parts (3D CAD)/EXTPRO-V1 1110.03-A Flange 2.sldprt
139.7 x 139.7 x 8.00 mm
