devsonni/Community-Extrusion-Compression-Moulding-Machies/Precious Plastic Parts (3D CAD)/EXTPRO-V1 2100.00-A Electronics box assembly.SLDASM

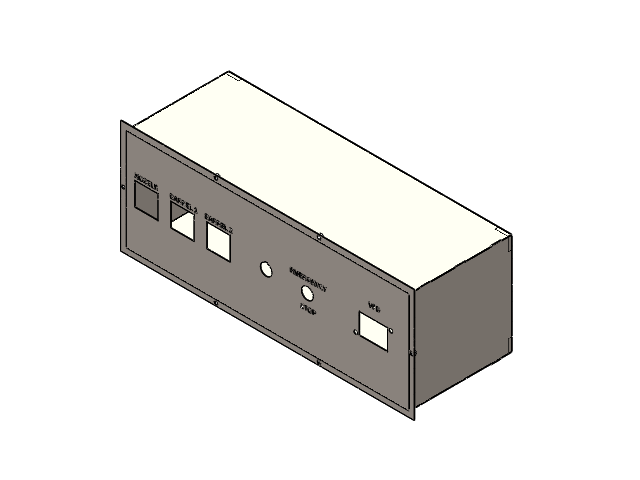
[picture p46: CAD file, 2021-08-28]
Precious Plastic Parts (3D CAD)/EXTPRO-V1 2100.00-A Electronics box assembly.SLDASM
EXTPRO-V1 2100.01-A Cover
EXTPRO-V1 2100.02-A Front
EXTPRO-V1 2100.03-A Side 2
EXTPRO-V1 2100.04-A Side 1
EXTPRO-V1 2100.05-A Side 3 x 2
EXTPRO-V1 2100.06-A Cover attachment x 4
EXTPRO-V1 14 M5 Nut x 6
EXTPRO-V1 15 M6x10 Socket head screw x 4
