devsonni/Community-Extrusion-Compression-Moulding-Machies/(list of files, cad)

Other CAD files:
Precious Plastic Parts (3D CAD)/EXTPRO-V1 1000.00-A Extruder.SLDDRW
Precious Plastic Parts (3D CAD)/EXTPRO-V1 1100.00-A Screw main assembly.SLDASM
Precious Plastic Parts (3D CAD)/EXTPRO-V1 1100.00-A Screw main assembly.SLDDRW
Precious Plastic Parts (3D CAD)/EXTPRO-V1 1100.01-A Barrel tip.SLDDRW
Precious Plastic Parts (3D CAD)/EXTPRO-V1 1100.01-A Nozzle.SLDDRW
Precious Plastic Parts (3D CAD)/EXTPRO-V1 1100.02-A Screw.SLDDRW
Precious Plastic Parts (3D CAD)/EXTPRO-V1 1100.02-A Screw.SLDPRT
Precious Plastic Parts (3D CAD)/EXTPRO-V1 1100.03-A Screw tip.SLDDRW
Precious Plastic Parts (3D CAD)/EXTPRO-V1 1100.03-A Screw tip.sldprt
Precious Plastic Parts (3D CAD)/EXTPRO-V1 1110.00-A Gearbox flange.SLDDRW
Precious Plastic Parts (3D CAD)/EXTPRO-V1 1110.02-A - Flange 1.SLDDRW
Precious Plastic Parts (3D CAD)/EXTPRO-V1 1110.03-A - Flange 2.SLDDRW
Precious Plastic Parts (3D CAD)/EXTPRO-V1 1110.03-A - Motor side flange.SLDDRW
Precious Plastic Parts (3D CAD)/EXTPRO-V1 1120.00-A Bearing Body _ Shaft.SLDDRW
Precious Plastic Parts (3D CAD)/EXTPRO-V1 1120.01-A Seal bearing spacer.SLDDRW
Precious Plastic Parts (3D CAD)/EXTPRO-V1 1120.02-A Coupling shaft.SLDDRW
Precious Plastic Parts (3D CAD)/EXTPRO-V1 1121.00-A Bearing body.SLDDRW
Precious Plastic Parts (3D CAD)/EXTPRO-V1 1121.01-A Transition Piece.SLDDRW
Precious Plastic Parts (3D CAD)/EXTPRO-V1 1121.01-A Transition Piece2.SLDDRW
Precious Plastic Parts (3D CAD)/EXTPRO-V1 1121.02-A Bearing body.SLDDRW
Precious Plastic Parts (3D CAD)/EXTPRO-V1 1130.00-A Barrel inlet(1).SLDDRW
Precious Plastic Parts (3D CAD)/EXTPRO-V1 1130.00-A Barrel inlet(2).SLDDRW
Precious Plastic Parts (3D CAD)/EXTPRO-V1 1130.00-A Barrel inlet.SLDDRW
Precious Plastic Parts (3D CAD)/EXTPRO-V1 1130.01-A Barrel inlet(1).SLDDRW
Precious Plastic Parts (3D CAD)/EXTPRO-V1 1130.01-A Barrel inlet.SLDDRW
Precious Plastic Parts (3D CAD)/EXTPRO-V1 1130.02-A Barrel flange 1.SLDDRW
Precious Plastic Parts (3D CAD)/EXTPRO-V1 1130.03-A Barrel flange 2.SLDDRW
Precious Plastic Parts (3D CAD)/EXTPRO-V1 1130.03-A Flange 2.SLDDRW
Precious Plastic Parts (3D CAD)/EXTPRO-V1 1140.00-A Barrel.SLDDRW
Precious Plastic Parts (3D CAD)/EXTPRO-V1 1140.01-A Barrel.SLDDRW
Precious Plastic Parts (3D CAD)/EXTPRO-V1 1140.02-A Barrel flange(1).SLDDRW
Precious Plastic Parts (3D CAD)/EXTPRO-V1 1140.02-A Barrel flange.SLDDRW
Precious Plastic Parts (3D CAD)/EXTPRO-V1 1140.03-A Barrel tip.SLDDRW
Precious Plastic Parts (3D CAD)/EXTPRO-V1 14 M5 Nut.SLDPRT
Precious Plastic Parts (3D CAD)/EXTPRO-V1 15 M6x10 Socket head screw (1).SLDPRT
Precious Plastic Parts (3D CAD)/EXTPRO-V1 15 M6x10 Socket head screw.SLDPRT
Precious Plastic Parts (3D CAD)/EXTPRO-V1 2000.01-A Electronics box support (1).SLDDRW
Precious Plastic Parts (3D CAD)/EXTPRO-V1 2000.01-A Electronics box support.SLDDRW
Precious Plastic Parts (3D CAD)/EXTPRO-V1 2100.00-A Electronics box assembly.SLDDRW
Precious Plastic Parts (3D CAD)/EXTPRO-V1 2100.02-A Front.SLDDRW
Precious Plastic Parts (3D CAD)/EXTPRO-V1 25 M5x15 mm Socket head screw.SLDPRT
Precious Plastic Parts (3D CAD)/EXTPRO-V1 26 M6 Washer (1).SLDPRT
Precious Plastic Parts (3D CAD)/EXTPRO-V1 26 M6 Washer.SLDPRT
Precious Plastic Parts (3D CAD)/EXTPRO-V1 27 M6x60 mm Socket head screw.SLDPRT
Precious Plastic Parts (3D CAD)/EXTPRO-V1 28 M6 Nut.SLDPRT
Precious Plastic Parts (3D CAD)/EXTPRO-V1 28 M6 Washer.SLDPRT
Precious Plastic Parts (3D CAD)/EXTPRO-V1 29 M8 Washer.SLDPRT
Precious Plastic Parts (3D CAD)/EXTPRO-V1 30 M8x45 Socket head screw.SLDPRT
Precious Plastic Parts (3D CAD)/EXTPRO-V1 3000.00-A Frame.SLDDRW
Precious Plastic Parts (3D CAD)/EXTPRO-V1 3000.01-A Main frame.SLDDRW
Precious Plastic Parts (3D CAD)/EXTPRO-V1 3000.02-A Top shelf.SLDDRW
Precious Plastic Parts (3D CAD)/EXTPRO-V1 31 M8 Nut.SLDPRT
Precious Plastic Parts (3D CAD)/EXTPRO-V1 32 M6x35 Socket head screw.SLDPRT
