devsonni/Community-Extrusion-Compression-Moulding-Machies/2D draft/Precious Plastic/EXTPRO-V1 0000.00-A Main assembly.PDF

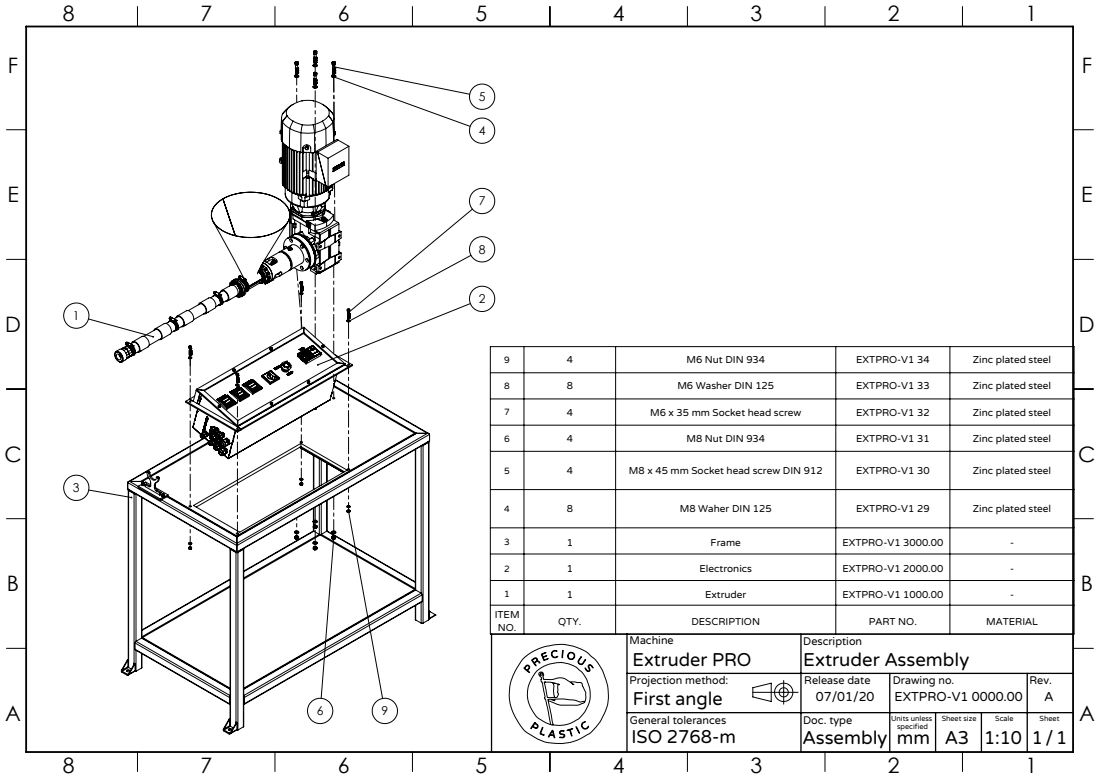
[picture p52: page 1]

9 | 4 | M6 Nut DIN 934 | EXTPRO-V1 34 | Zinc plated steel

8 | 8 | M6 Washer DIN 125 | EXTPRO-V1 33 | Zinc plated steel

7 | 4 | M6 x 35 mm Socket head screw | EXTPRO-V1 32 | Zinc plated steel

6 | 4 | M8 Nut DIN 934 | EXTPRO-V1 31 | Zinc plated steel

5 | 4 | M8 x 45 mm Socket head screw DIN 912 | EXTPRO-V1 30 | Zinc plated steel

4 | 8 | M8 Waher DIN 125 | EXTPRO-V1 29 | Zinc plated steel

3 | 1 | Frame | EXTPRO-V1 3000.00 | -

2 | 1 | Electronics | EXTPRO-V1 2000.00 | -

1 | 1 | Extruder | EXTPRO-V1 1000.00 | -
ITEM NO. | QTY. | DESCRIPTION | PART NO. | MATERIAL

Machine Extruder PRO | Description Extruder Assembly
Projection method: First angle | Release date 07/01/20 | Drawing no. EXTPRO-V1 0000.00 | Rev. A
General tolerances ISO 2768-m | Doc. type Assembly | Units unless specified mm | Sheet size A3 | Scale 1:10 | Sheet 1 1 /
