devsonni/Community-Extrusion-Compression-Moulding-Machies/2D draft/Modified draft/Bearing Body Modified.pdf

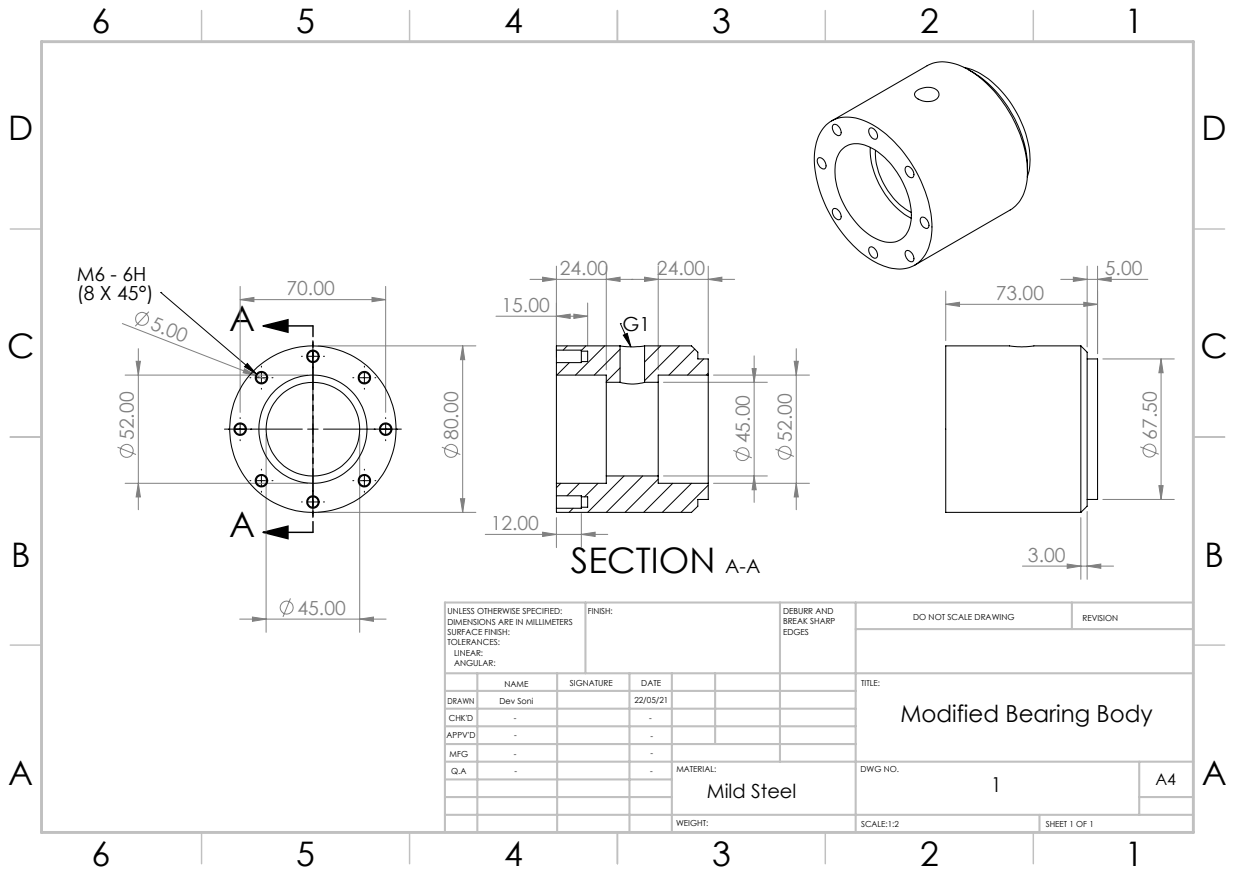
[picture p57: page 1]
SECTION A-A; FINISH:; DEBURR AND; BREAK SHARP; DO NOT SCALE DRAWING; REVISION; SCALE:1:2; SHEET 1 OF 1

UNLESS OTHERWISE SPECIFIED:
DIMENSIONS ARE IN MILLIMETERS
SURFACE FINISH:
TOLERANCES:
LINEAR:
ANGULAR:

NAME | SIGNATURE | DATE | | | | TITLE: Modified Bearing Body

DRAWN | Dev Soni | | 22/05/21
CHK'D | - | | -
APPV'D | - | | -
MFG | - | | -
Q.A | - | | - | MATERIAL: Mild Steel | DWG NO. 1 | A4
