devsonni/Community-Extrusion-Compression-Moulding-Machies/2D draft/Modified draft/EXTPRO-V1 1121.01-A Transition Piece.pdf

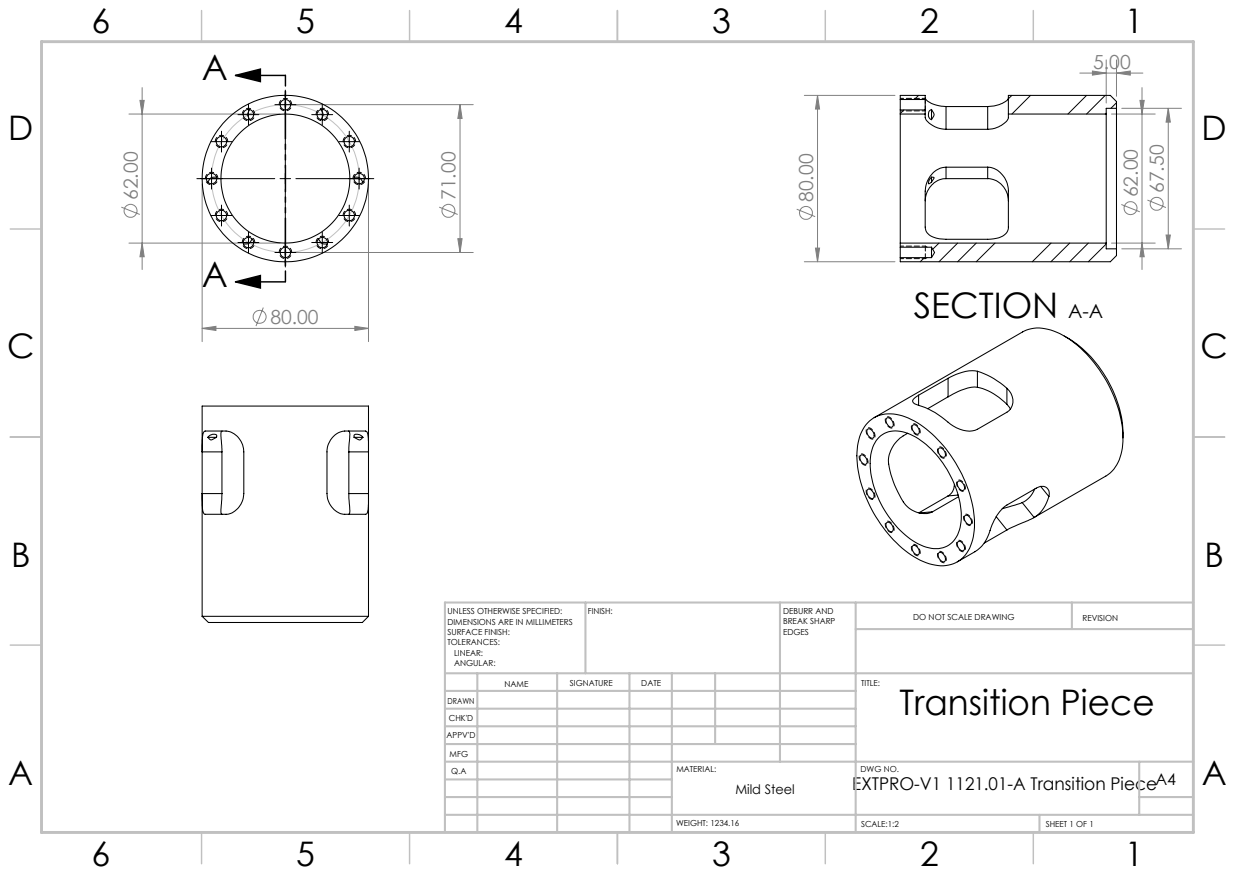
[picture p58: page 1]
SECTION A-A; FINISH:; DEBURR AND; BREAK SHARP; DO NOT SCALE DRAWING; REVISION; SCALE:1:2; SHEET 1 OF 1; WEIGHT: 1234.16

UNLESS OTHERWISE SPECIFIED:
DIMENSIONS ARE IN MILLIMETERS
SURFACE FINISH:
TOLERANCES:
LINEAR:
ANGULAR:

NAME | SIGNATURE | DATE | | | | TITLE: Transition Piece

DRAWN
CHK'D
APPV'D
MFG
Q.A | | | | MATERIAL: EXTPRO-V1 1121.01-A Transition Piece | DWG NO. | A4 Mild Steel
