devsonni/Community-Extrusion-Compression-Moulding-Machies/2D draft/Modified draft/Modified Coupling Shaft.pdf

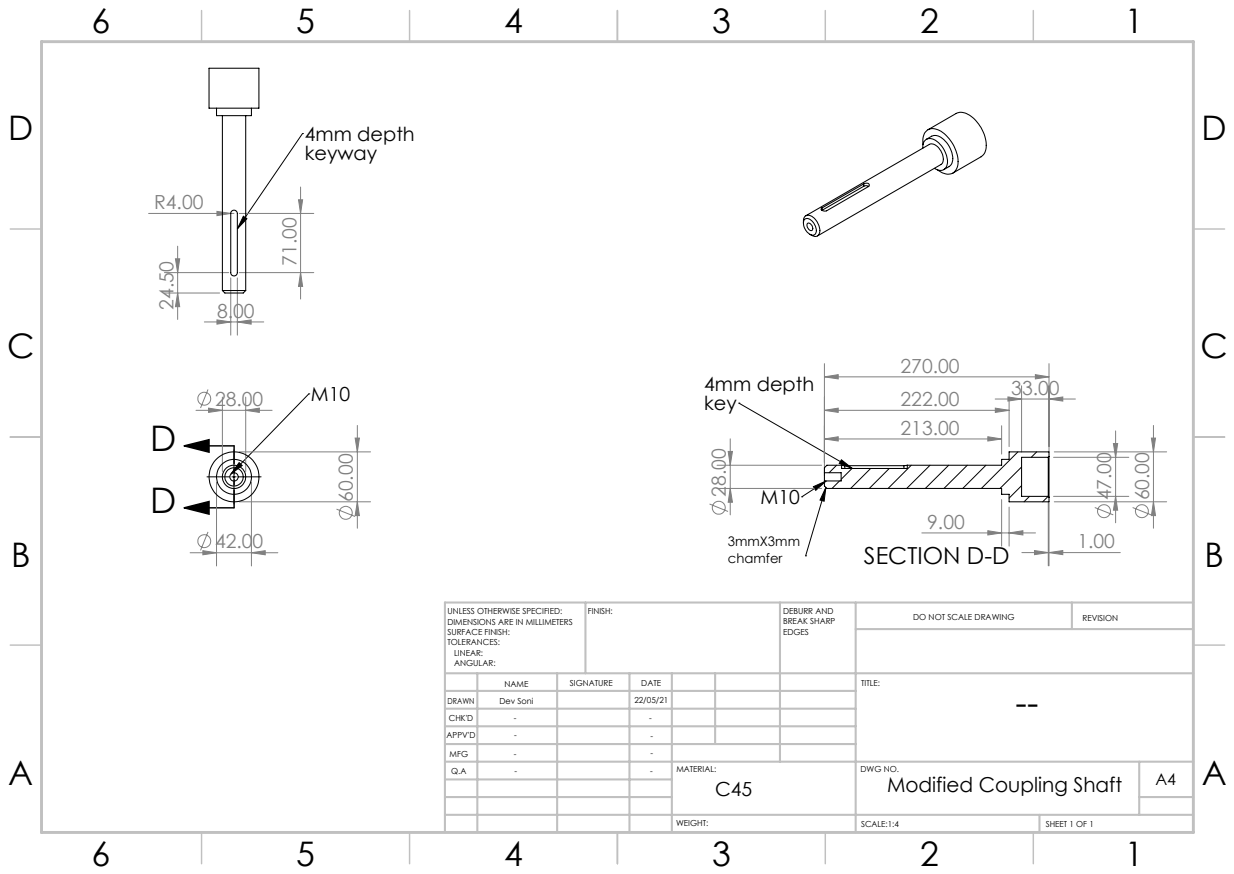
[picture p59: page 1]
SECTION D-D; 4mm depth; FINISH:; DEBURR AND; BREAK SHARP; DO NOT SCALE DRAWING; REVISION; SCALE:1:4; SHEET 1 OF 1

UNLESS OTHERWISE SPECIFIED:
DIMENSIONS ARE IN MILLIMETERS
SURFACE FINISH:
TOLERANCES:
LINEAR:
ANGULAR:

NAME | SIGNATURE | DATE | | | | TITLE: --

DRAWN | Dev Soni | | 22/05/21
CHK'D | - | | -
APPV'D | - | | -
MFG | - | | -
Q.A | - | | - | MATERIAL: C45 | DWG NO. Modified Coupling Shaft | A4
