devsonni/Community-Extrusion-Compression-Moulding-Machies/2D draft/Precious Plastic/EXTPRO-V1 1110.00-A Gearbox flange.PDF

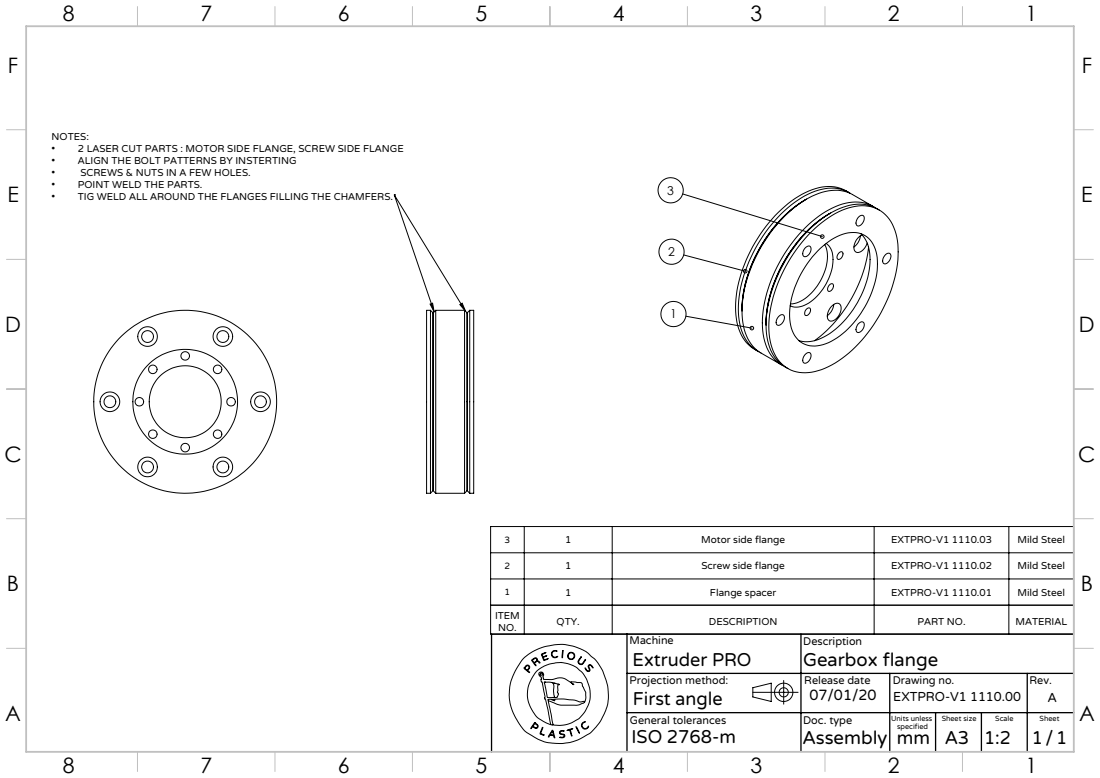
[picture p61: page 1]
First angle; Projection method:

NOTES:
• 2 LASER CUT PARTS : MOTOR SIDE FLANGE, SCREW SIDE FLANGE
• ALIGN THE BOLT PATTERNS BY INSTERTING
• SCREWS & NUTS IN A FEW HOLES.
• POINT WELD THE PARTS.

• TIG WELD ALL AROUND THE FLANGES FILLING THE CHAMFERS.

3 | 1 | Motor side flange | EXTPRO-V1 1110.03 | Mild Steel

2 | 1 | Screw side flange | EXTPRO-V1 1110.02 | Mild Steel

1 | 1 | Flange spacer | EXTPRO-V1 1110.01 | Mild Steel

ITEM NO. | QTY. | DESCRIPTION | PART NO. | MATERIAL

Machine Extruder PRO | Description Gearbox flange

Release date 07/01/20 | Drawing no. EXTPRO-V1 1110.00 | Rev. A

General tolerances ISO 2768-m | Doc. type Assembly | Units unless specified mm | Sheet size A3 | Scale 1:2 | Sheet 1 1 /
